cscott/rain-barrel/Transflective/README

To do:
1) add STEMMA QT socket(s)
2) add power regulator (5V to 3.3V)
3) add I2C resistors?
--
on base plate: (pads to regulate input to 12v (adj) / 5v / 3.3V) nah
2 STEMMA QT / 4 pin header(s)
(2) 3 pin (+5V / SIG / GND) header to supply (5V-diode drop) outside, and
 to supply 5V power
 connect to 5V backfeed on unused HUZZAH pin used in basement motor shield
Feather!
IDC connector to display
WATER_GPIO (another 5v/sig/gnd header?)
breadboard mounting
motor shield
rasp pi nano footprint -> (5V/SIG/GND) connector for snitch & routed i2c connection
----
To do: assign pin for DS_CS
Figure out how to wire-AND the pump pressure switch
  (maybe add an H-Bridge, and wire the switch to the enable input)
Routing
---
Both:
Feather!
Cap sense (i2c, 3.3V)
LCD (SPI)

Basement:
Motor Shield
Flow meter (i2c, +5V supply)
Smrty Snitch (i2c, is there a 5V supply?)
Water level sensor input?
Breadboard for smrty snitch
 (presumably 12V-ish input to motor shield, 12->5V conversion, 5V backfeed to feather through unused HUZZAH pin)

Outside:
ADS1115 A/D converter (i2c, 3.3V)
Breadboard (Vin to +/- 9V, 12V->5V switch converter, 2x 5V/SIG/GND one used to power magtag through 1N4001 diode)
 (how was the ADS1115 connected?)

Datasheets:

ADP1650 LED driver:
https://www.analog.com/media/en/technical-documentation/data-sheets/ADP1650.pdf
https://www.digikey.com/short/223nhvrn

CAP1298 Capacitive touch:
https://www.microchip.com/en-us/product/CAP1298
https://ww1.microchip.com/downloads/en/DeviceDoc/00001571B.pdf
https://www.microchip.com/content/dam/mchp/documents/OTH/ApplicationNotes/ApplicationNotes/01492A.pdf
App note: https://www.nxp.com/docs/en/application-note/AN3747.pdf

LCD panel: Displaytech 128240D FC BW-3 Graphic LCD
Digikey 1756-1047-ND or Mouser 758-S128240DFCBW-3
https://www.ebay.com/itm/293977786571
https://www.digikey.com/short/012dbnz2
https://www.seacomp.com/sites/default/files/datasheets/128240D-Series-Displaytech-Spec.pdf

Driver chip: ST7529:
https://www.sitronix.com.tw/en/products/industrial-display-driver-ic/gray-scale-stn-lcd-driver-ic/
https://www.crystalfontz.com/controllers/Sitronix/ST7529/
https://www.crystalfontz.com/controllers/Sitronix/ST7529/287/ (datasheet)

Waterproof enclosure: (haven't bought this yet)
https://www.adafruit.com/product/905
Dimensions https://cdn-shop.adafruit.com/datasheets/175mmenclosurediagram.pdf

(Alternative LED drivers:
https://www.diodes.com/assets/Datasheets/AL3644.pdf
https://www.ti.com/lit/ds/symlink/lm3642.pdf
)

Model of raspberry pi pico:
https://www.hackster.io/news/nicolo-carandini-s-3d-model-brings-an-accurate-raspberry-pi-pico-board-to-your-kicad-projects-7a2dffff9c56
Featherwing template:
https://github.com/ppelleti/FeatherWing-template-KiCad

Kicad helpers:
https://techexplorations.com/blog/kicad/blog-kicad-5-recipe-how-to-create-a-new-component-symbol/
https://techexplorations.com/kicad-4-book/index-p=112.html

BOM:                                       LCD        Rear       Have    Need
609-F314-1A7H1-11036CT-ND‎ (FPC connector)  1                              2 x
               (.01uF 0805 capacitor)      1                       8      -
732-8045-1-ND  (.1uF 0805 capacitor)       2                       9      -
732-7664-1-ND (1uF 0805 capacitor)         13                      9      4 x
732-7624-1-ND‎ (10 uF 0805 X5R capacitor)   2                              4 x
1175-1622-ND (2x7 SMD pin header)          1                              2 x
              STEMMA QT SMD                2           2          10      -
F12094CT-ND‎ (1uH 0805 inductor)            1                              2 x
RNCP0805FTD200RCT-ND (200 ohm 0805)        2                              4 x
RMCF0805JT10K0CT-ND (10k 0805)             2                              4 x
RMCF0805JT1M00CT-ND (1M 0805)              1                              2 x
CAP1298                                    1
ADP1650ACPZ-R7CT-ND (led driver)           1                       2      -
3.3V reg                                   1                      1+2     -
Feather headers                                         2         ?
SN74LVC1G02DBVRG4-ND (NOR gate)                         1                 -
  74LVC1G02W5-7DICT-ND‎                                                    1 x
2648-SC0915CT-ND (Raspberry Pi Pico)                    1                 1 x
THT 10k                                                 3       lots      -

0805 (2012 metric)
