cscott/rain-barrel/PCB-NOTES.txt

v1 of "Rear-Panel" PCB:

* OR gate should be 3.3V supply, not 5V
* 2x7 header should be rotated 180, either on this board or the other
* Swap F0 and F3
  (2022-03-19 why? apparently because F3 is hardware CS for SPI.
  DS_CS should be F3, Pressure switch should be F1
* Probably should have a jumper for LCD_RST
* Probably should add another schottkey diode heading *into* the 5V
  net, with a pad on the input to connect to external power
* Probably should label "A2" on the board as "5V IN"

v1 of "LCD Panel" PCB:
* The LED driver chip footprint has a center ground pad which
is much too large and threatens to short out against the pins
* C18 is stepped on by the 2x7 header.  "Use local reg" is a little
too close as well.
* Footprint for 2x7 header (a) pads should be wider, they don't reach
the ends of the pins which makes it hard to line up, and (b) the
silkscreen outline is too small, again can't be seen when the
component is placed.
* The X component of the top/bottom tabs is a little too large, needs
to be trimmed down to fit better.  (The side tabs are fine.)
* capacitors for LCD are wrong (see Transflective/NOTES.txt)

(see also Transflective/NOTES.txt)
