cscott/rain-barrel/feather-top.stl

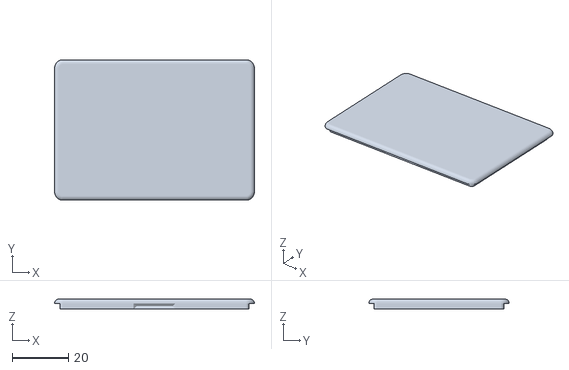
[picture p1: CAD file, 2021-06-01]
feather-top.stl
71.0 x 49.9 x 3.50
