cscott/rain-barrel/Transflective/ADP1650ACPZR7/CP_10_9_ADI.step

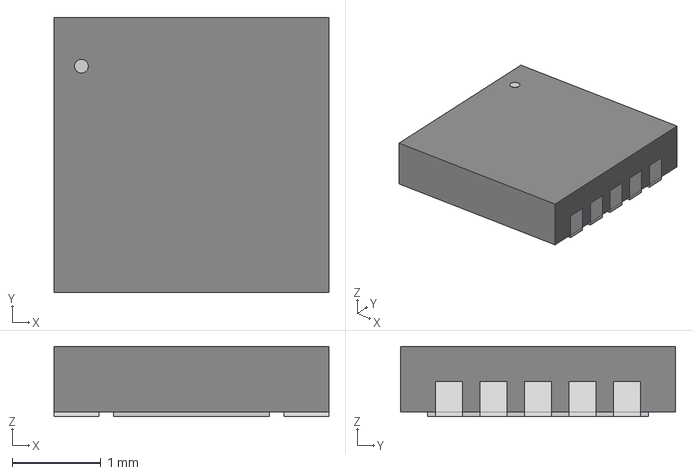
[picture p2: CAD file, 2021-09-28]
Transflective/ADP1650ACPZR7/CP_10_9_ADI.step
3.10 x 3.10 x 0.79 mm
