cscott/rain-barrel/Transflective/LCD-Fixup/BM04B-SRSS-TB-LF--SN---3DModel-STEP-56544.STEP

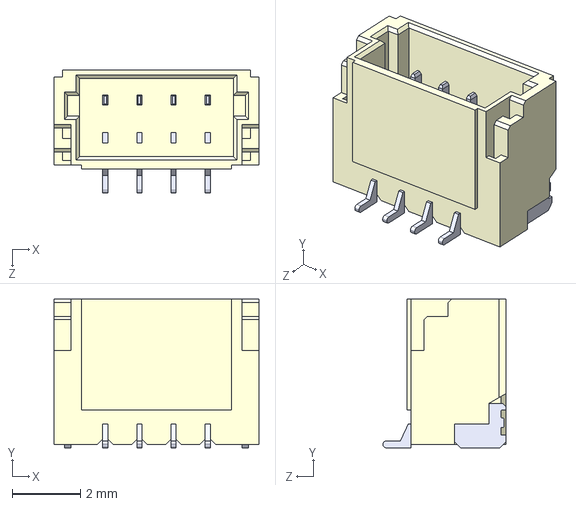
[picture p3: CAD file, 2021-10-04]
Transflective/LCD-Fixup/BM04B-SRSS-TB-LF--SN---3DModel-STEP-56544.STEP
6.00 x 4.35 x 3.60 mm
