cscott/rain-barrel/Transflective/Rear-Panel/B3B-XH-A-LF--SN---3DModel-STEP-269445.STEP

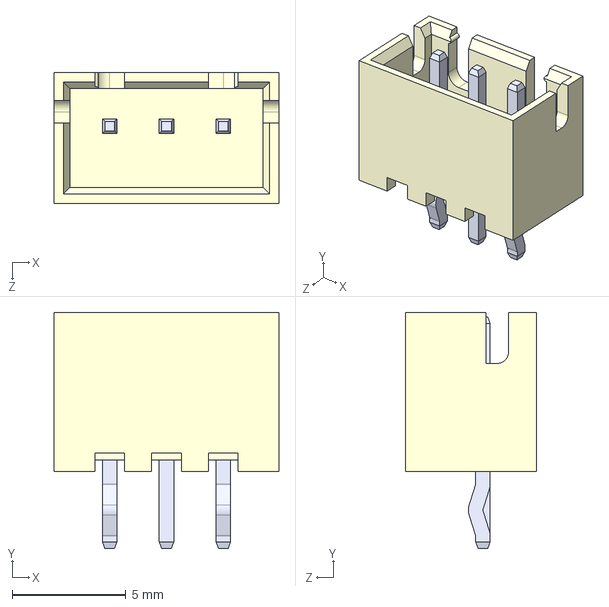
[picture p4: CAD file, 2021-10-04]
Transflective/Rear-Panel/B3B-XH-A-LF--SN---3DModel-STEP-269445.STEP
9.90 x 10.4 x 5.75 mm
