cscott/rain-barrel/esp32-rainbarrel/test/test_desktop/README.md

This directory contains tests to run natively on the host.
