cscott/rain-barrel/Transflective/Rear-Panel/Transflective.pdf

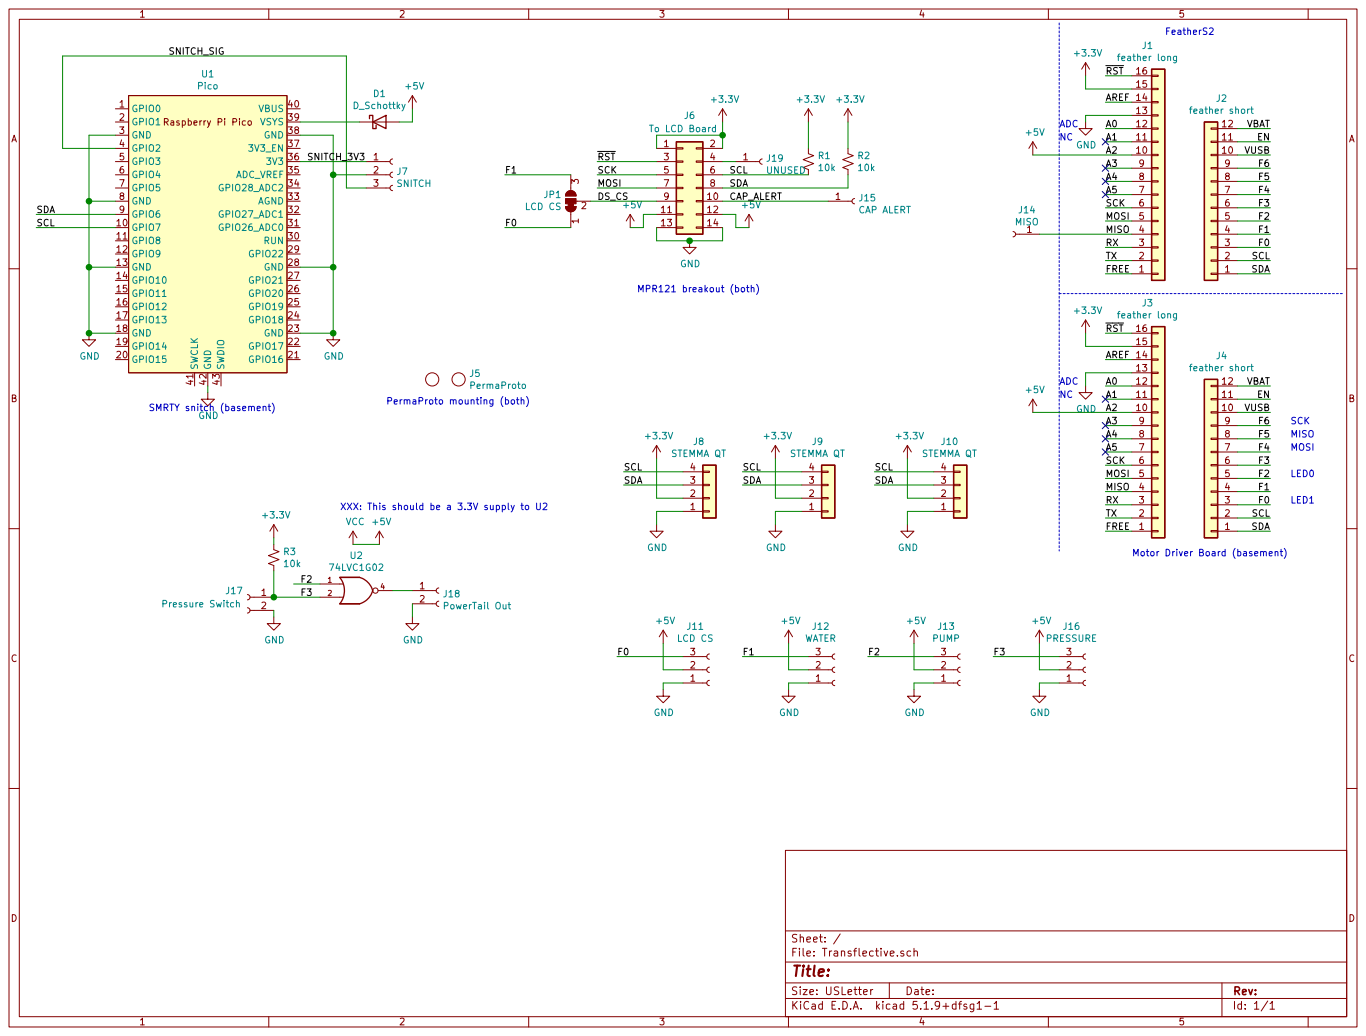
[picture p5: page 1]

PermaProto mounting (both) SMRTY snitch (basement)

Motor Driver Board (basement)

Id: 1/1 Title: File: Transflective.sch Sheet: /
