cscott/rain-barrel/Transflective/LCD-Tester/LCD-Tester.pdf

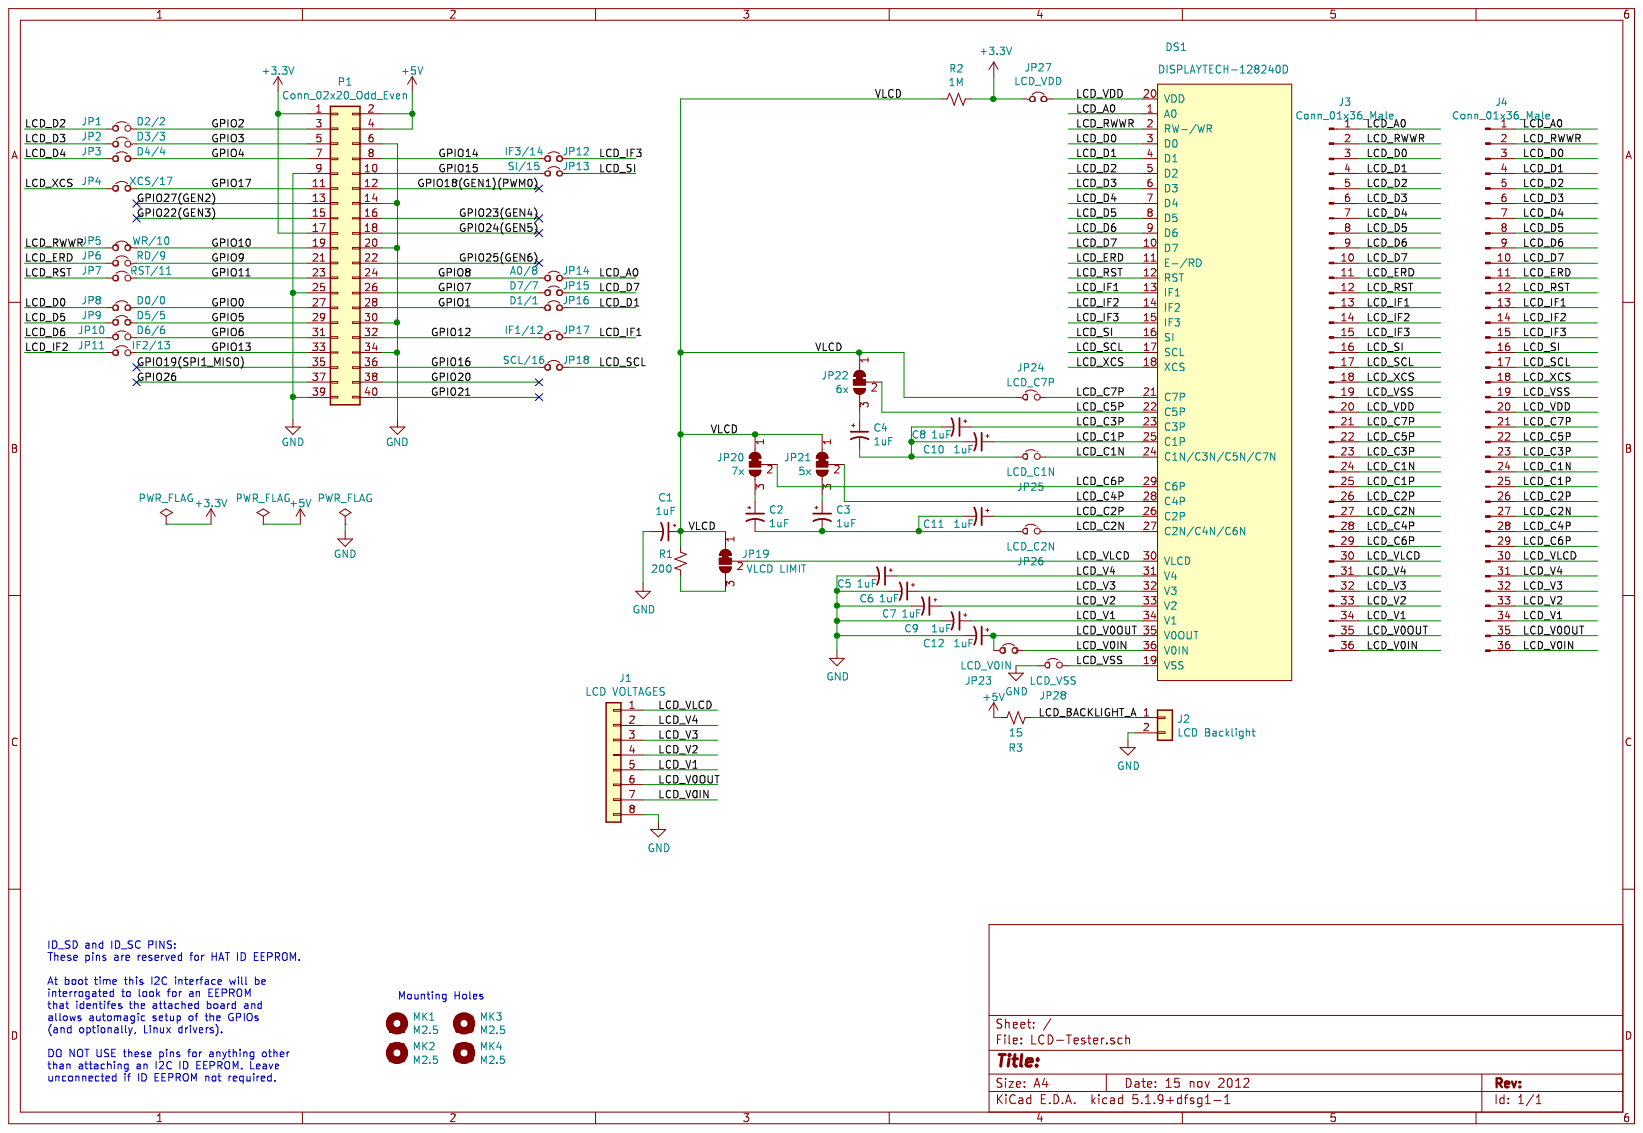
[picture p6: page 1]
