cscott/rain-barrel/Transflective/LCD-Panel/LCD-panel.pdf

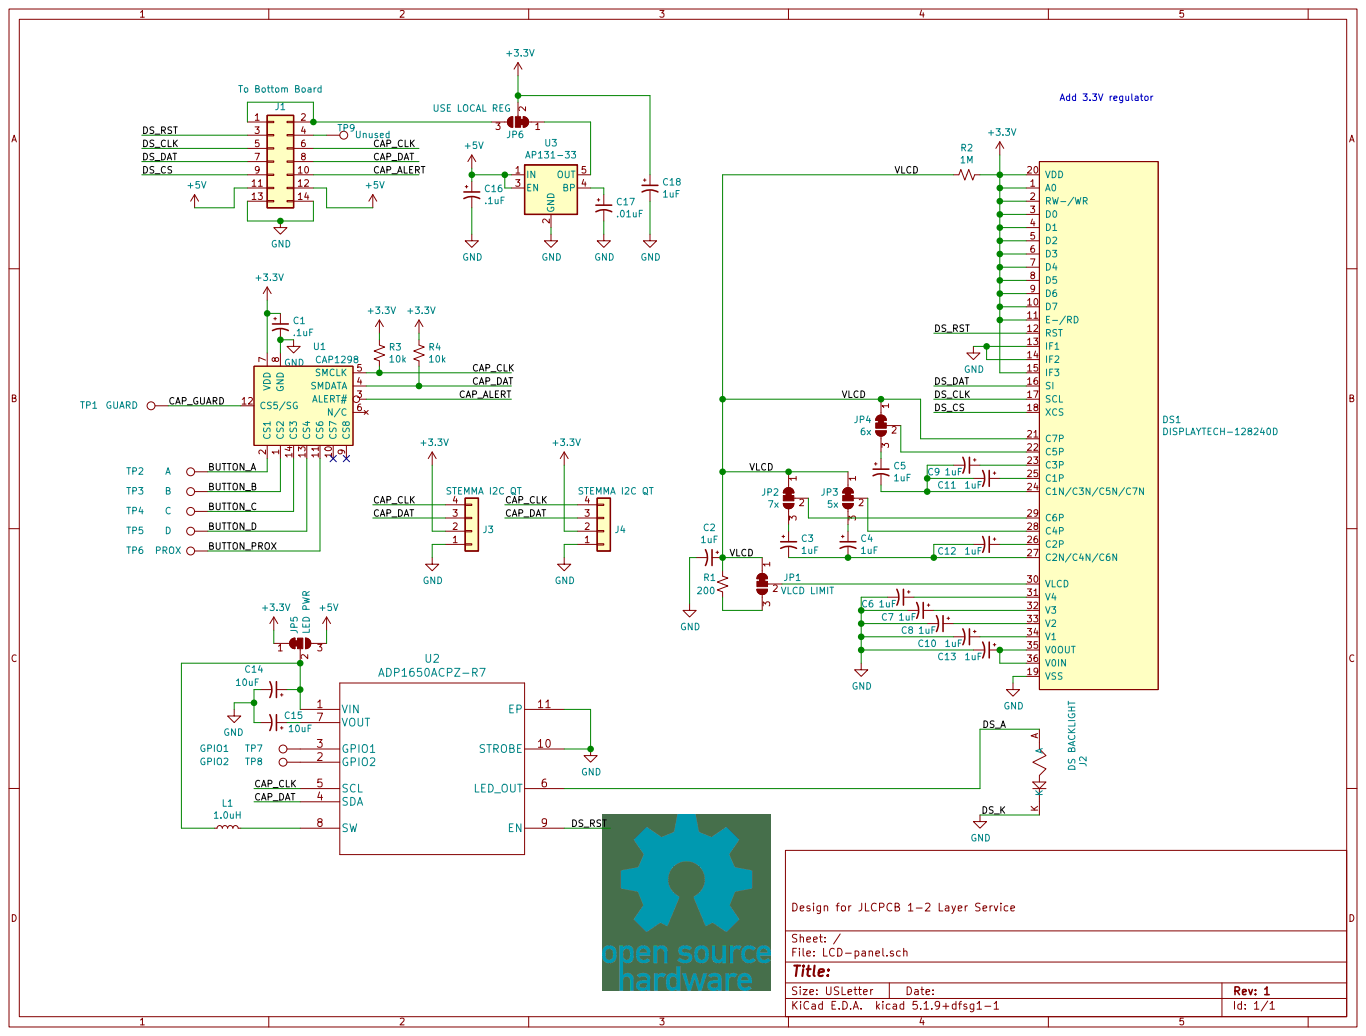
[picture p7: page 1]

2 ALERT# 3 SMDATA 4 SMCLK 5 N/C 6 VDD

File: LCD-panel.sch Sheet: / Design for JLCPCB 1-2 Layer Service
