cscott/rain-barrel/(list of files, drawings)

Other design files:
LevelAmps.fzz
SMRTYComparator.fzz
SMRTYSnitch2.fzz
SMRTYSnitch3.fzz
SMRTYSnitch.fzz
