cscott/rain-barrel/Transflective/Turbine-PCB/Turbine-PCB.kicad_pcb

## KiCad design Transflective/Turbine-PCB/Turbine-PCB.kicad_pcb (2023-07-10)

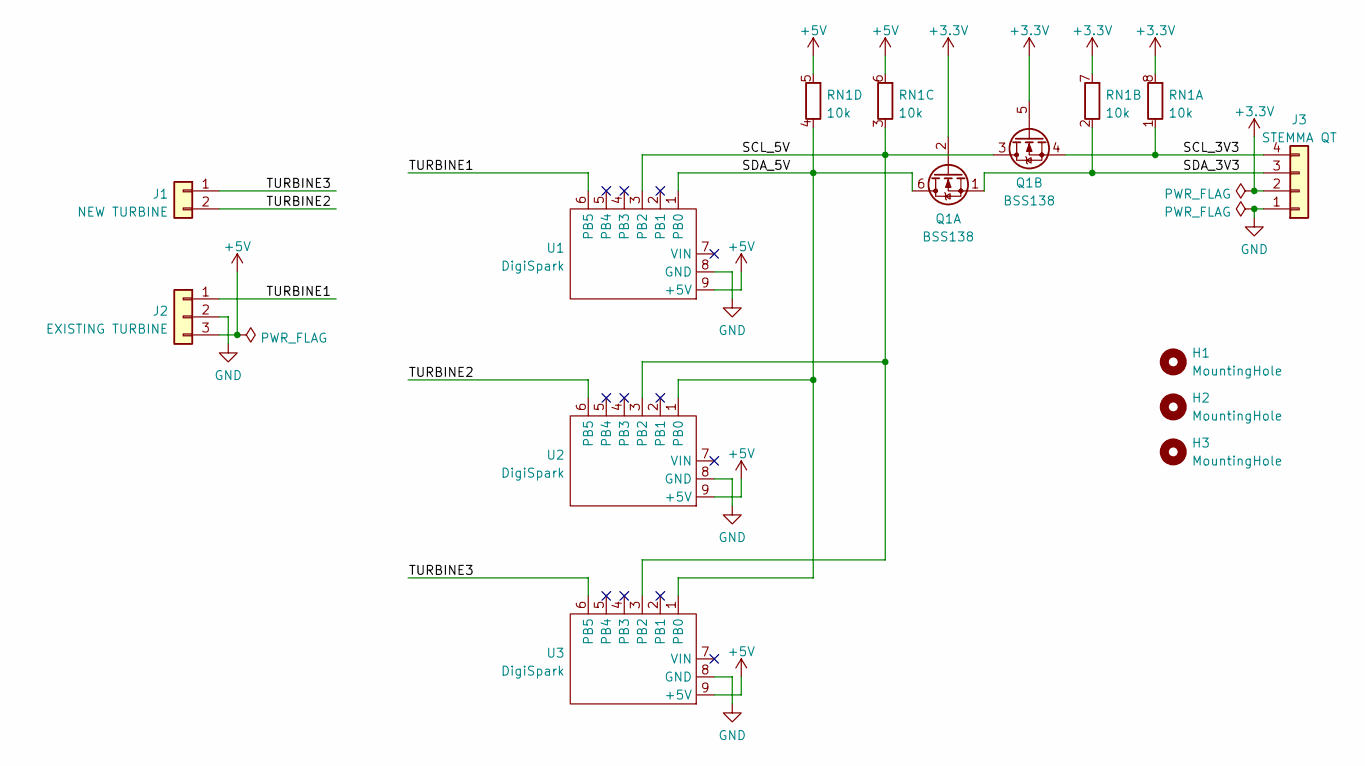
[picture p8: schematic Turbine-PCB.kicad_sch]

Parts:
H1, H2, H3: MountingHole; MountingHole_3.2mm_M3
J1: NEW TURBINE; JST_XH_B2B-XH-A_1x02_P2.50mm_Vertical
J2: EXISTING TURBINE; JST_XH_B3B-XH-A_1x03_P2.50mm_Vertical
J3: STEMMA QT; JST-SH-4-VERT-SMD
Q1: BSS138; SOT-363_SC-70-6_Handsoldering
RN1: 10k; R_Array_Convex_4x1206
U1, U2, U3: DigiSpark; Digispark

Connections:
+3.3V: J3.2, Q1.2 (G), Q1.5 (G), RN1.7 (R2.2), RN1.8 (R1.2)
+5V: J2.3, RN1.5 (R4.2), RN1.6 (R3.2), U1.9 (+5V), U2.9 (+5V), U3.9 (+5V)
/SCL_3V3: J3.4, Q1.4 (S), RN1.1 (R1.1)
/SCL_5V: Q1.3 (D), RN1.3 (R3.1), U1.3 (PB2), U2.3 (PB2), U3.3 (PB2)
/SDA_3V3: J3.3, Q1.1 (S), RN1.2 (R2.1)
/SDA_5V: Q1.6 (D), RN1.4 (R4.1), U1.1 (PB0), U2.1 (PB0), U3.1 (PB0)
/TURBINE1: J2.1, U1.6 (PB5)
/TURBINE2: J1.2, U2.6 (PB5)
/TURBINE3: J1.1, U3.6 (PB5)
GND: J2.2, J3.1, U1.8 (GND), U2.8 (GND), U3.8 (GND)

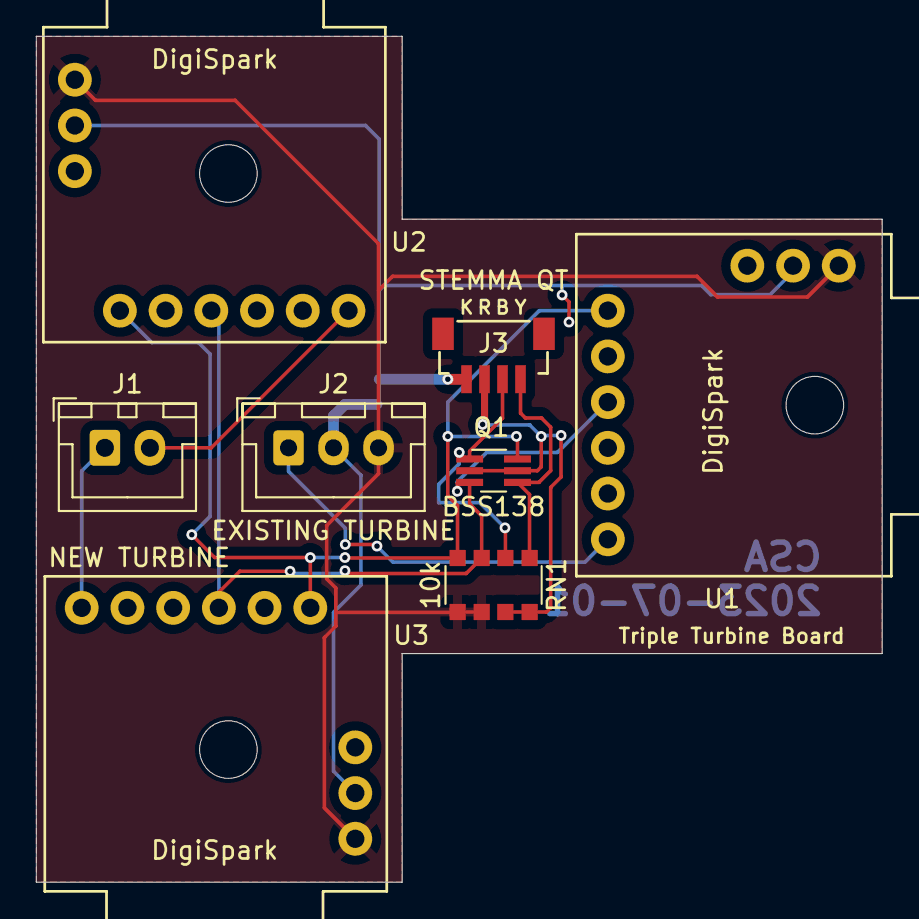
[picture p9: board Turbine-PCB.kicad_pcb from above]

Board: 2 copper layers, 47.0 x 47.0 mm, 11 parts (0 on the bottom side), 10 nets.
