cscott/rain-barrel/Transflective/Level-Amp-PCB/Level-Amp-PCB.kicad_pcb

## KiCad design Transflective/Level-Amp-PCB/Level-Amp-PCB.kicad_pcb (2023-07-10)

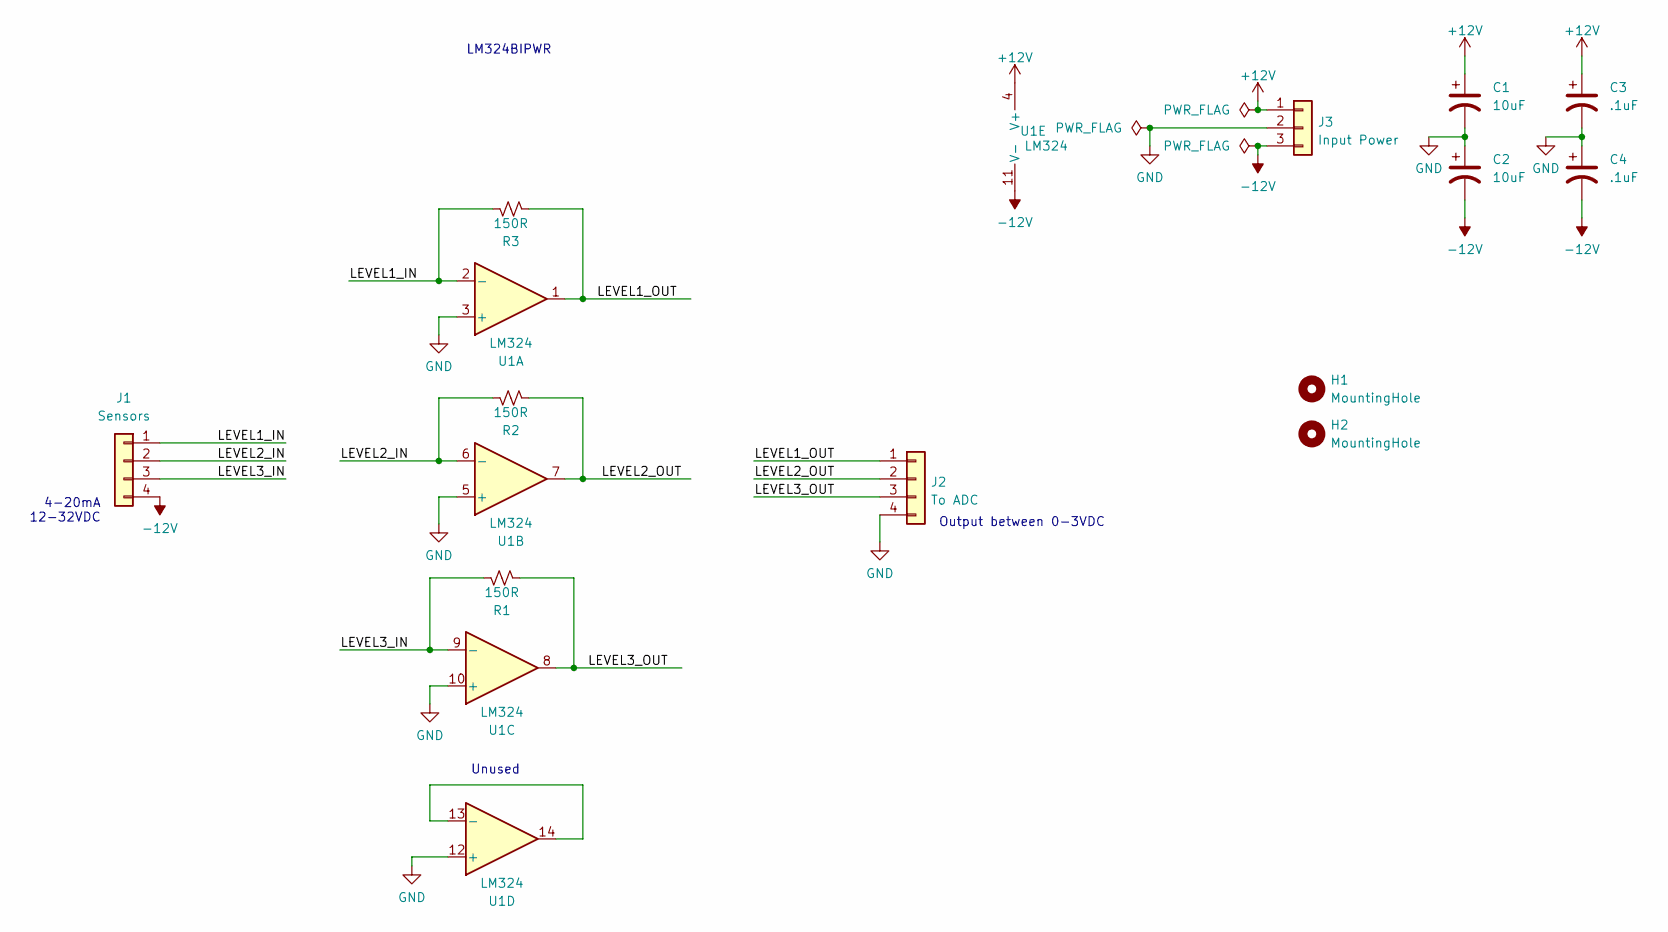
[picture p10: schematic Level-Amp-PCB.kicad_sch]

Parts:
C1, C2: 10uF; CP_EIA-2012-15_AVX-P_Pad1.30x1.05mm_HandSolder
C3, C4: .1uF; CP_EIA-2012-15_AVX-P_Pad1.30x1.05mm_HandSolder
H1, H2: MountingHole; MountingHole_3.2mm_M3
J1: Sensors; JST_XH_B4B-XH-A_1x04_P2.50mm_Vertical
J2: To ADC; JST_XH_B4B-XH-A_1x04_P2.50mm_Vertical
J3: Input Power; JST_XH_B3B-XH-A_1x03_P2.50mm_Vertical
R1, R2, R3: 150R; R_0805_2012Metric_Pad1.20x1.40mm_HandSolder
U1: LM324; TSSOP-14_4.4x5mm_P0.65mm

Connections:
+12V: C1.1, C3.1, J3.1, U1.4 (V+)
-12V: C2.2, C4.2, J1.4, J3.3, U1.11 (V-)
/LEVEL1_IN: J1.1, R3.1, U1.2 (-)
/LEVEL1_OUT: J2.1, R3.2, U1.1
/LEVEL2_IN: J1.2, R2.1, U1.6 (-)
/LEVEL2_OUT: J2.2, R2.2, U1.7
/LEVEL3_IN: J1.3, R1.1, U1.9 (-)
/LEVEL3_OUT: J2.3, R1.2, U1.8
GND: C1.2, C2.1, C3.2, C4.1, J2.4, J3.2, U1.3 (+), U1.5 (+), U1.10 (+), U1.12 (+)
unnamed: U1.13 (-), U1.14

Notes on the sheet:
4-20mA 12-32VDC
Output between 0-3VDC
LM324BIPWR
Unused

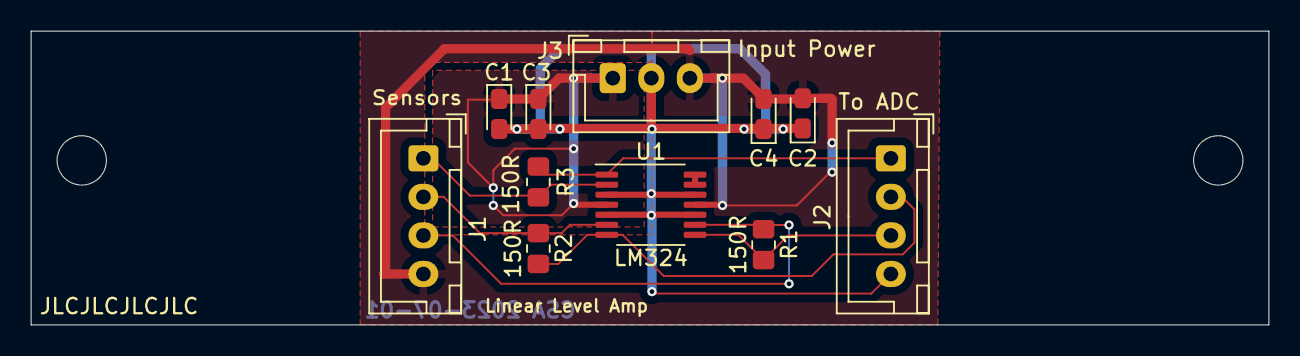
[picture p11: board Level-Amp-PCB.kicad_pcb from above]

Board: 2 copper layers, 80.3 x 19.1 mm, 13 parts (0 on the bottom side), 10 nets.
