cscott/rain-barrel/Transflective/Level-Chopper/Level-Chopper.kicad_pcb

## KiCad design Transflective/Level-Chopper/Level-Chopper.kicad_pcb (2023-07-10)

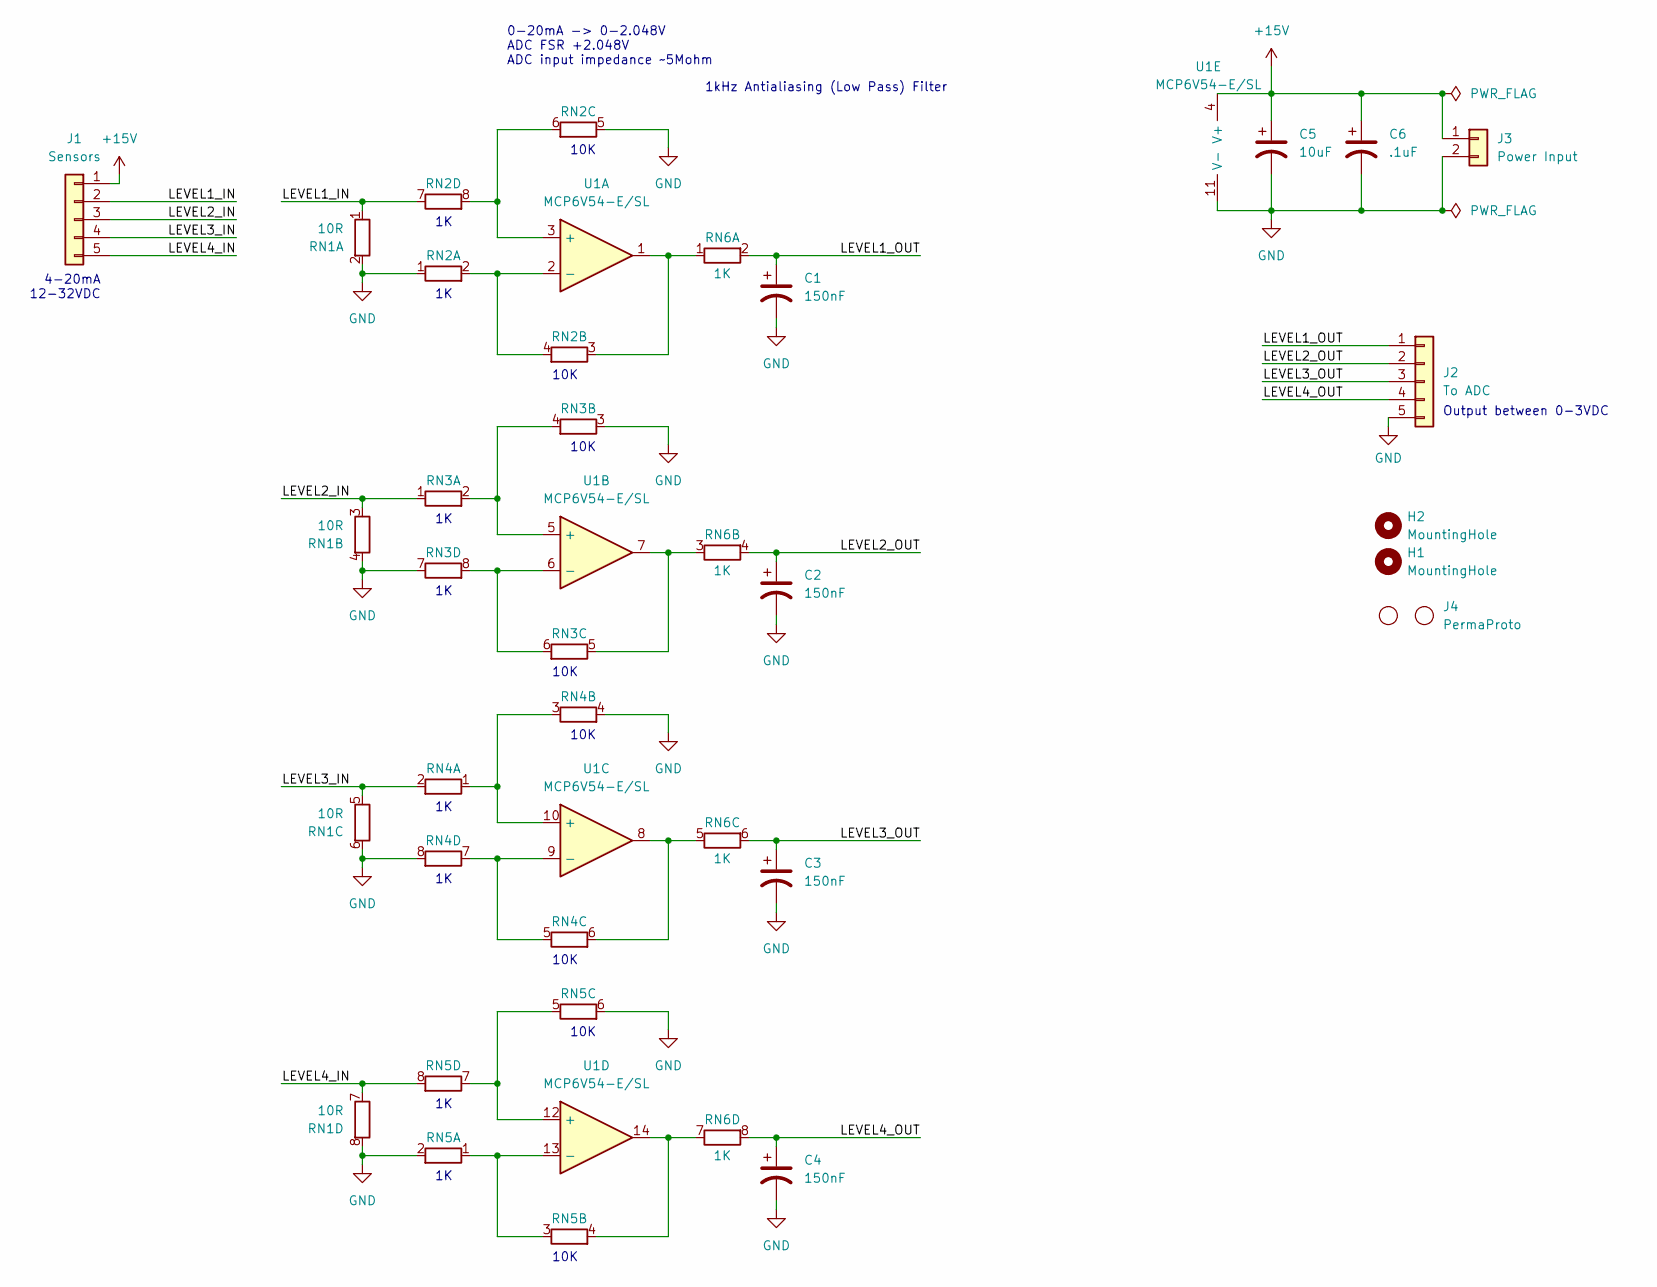
[picture p12: schematic Level-Chopper.kicad_sch]

Parts:
C1, C2, C3, C4: 150nF; CP_EIA-2012-15_AVX-P_Pad1.30x1.05mm_HandSolder
C5: 10uF; CP_EIA-2012-15_AVX-P_Pad1.30x1.05mm_HandSolder
C6: .1uF; CP_EIA-2012-15_AVX-P_Pad1.30x1.05mm_HandSolder
H1, H2: MountingHole; MountingHole_3.2mm_M3
J1: Sensors; JST_XH_B5B-XH-A_1x05_P2.50mm_Vertical
J2: To ADC; JST_XH_B5B-XH-A_1x05_P2.50mm_Vertical
J3: Power Input; JST_XH_B2B-XH-A_1x02_P2.50mm_Vertical
J4: PermaProto
RN1: 10R; RES_ACAS_0612_VIS
RN2, RN3, RN4, RN5: 1K/10k; RES_ACAS_0612_VIS
RN6: 1K; RES_ACAS_0612_VIS
U1: MCP6V54-E/SL; SOIC-14_3.9x8.7mm_P1.27mm

Connections:
+15V: C5.1, C6.1, J1.1, J3.1, U1.4 (V+)
/LEVEL1_IN: J1.2, RN1.1 (R1.1), RN2.7 (R4.1)
/LEVEL1_OUT: C1.1, J2.1, RN6.2 (R1.2)
/LEVEL2_IN: J1.3, RN1.3 (R2.1), RN3.1 (R1.1)
/LEVEL2_OUT: C2.1, J2.2, RN6.4 (R2.2)
/LEVEL3_IN: J1.4, RN1.5 (R3.1), RN4.2 (R1.2)
/LEVEL3_OUT: C3.1, J2.3, RN6.6 (R3.2)
/LEVEL4_IN: J1.5, RN1.7 (R4.1), RN5.8 (R4.2)
/LEVEL4_OUT: C4.1, J2.4, RN6.8 (R4.2)
GND: C1.2, C2.2, C3.2, C4.2, C5.2, C6.2, J2.5, J3.2, RN1.2 (R1.2), RN1.4 (R2.2), RN1.6 (R3.2), RN1.8 (R4.2), RN2.1 (R1.1), RN2.5 (R3.1), RN3.3 (R2.1), RN3.7 (R4.1), RN4.4 (R2.2), RN4.8 (R4.2), RN5.2 (R1.2), RN5.6 (R3.2), U1.11 (V-)
unnamed: RN2.2 (R1.2), RN2.4 (R2.2), U1.2 (-)
unnamed: RN2.3 (R2.1), RN6.1 (R1.1), U1.1
unnamed: RN2.6 (R3.2), RN2.8 (R4.2), U1.3 (+)
unnamed: RN3.2 (R1.2), RN3.4 (R2.2), U1.5 (+)
unnamed: RN3.5 (R3.1), RN6.3 (R2.1), U1.7
unnamed: RN3.6 (R3.2), RN3.8 (R4.2), U1.6 (-)
unnamed: RN4.1 (R1.1), RN4.3 (R2.1), U1.10 (+)
unnamed: RN4.5 (R3.1), RN4.7 (R4.1), U1.9 (-)
unnamed: RN4.6 (R3.2), RN6.5 (R3.1), U1.8
unnamed: RN5.1 (R1.1), RN5.3 (R2.1), U1.13 (-)
unnamed: RN5.4 (R2.2), RN6.7 (R4.1), U1.14
unnamed: RN5.5 (R3.1), RN5.7 (R4.1), U1.12 (+)

Notes on the sheet:
0-20mA -> 0-2.048V ADC FSR +2.048V ADC input impedance ~5Mohm
1kHz Antialiasing (Low Pass) Filter
10K
4-20mA 12-32VDC
Output between 0-3VDC

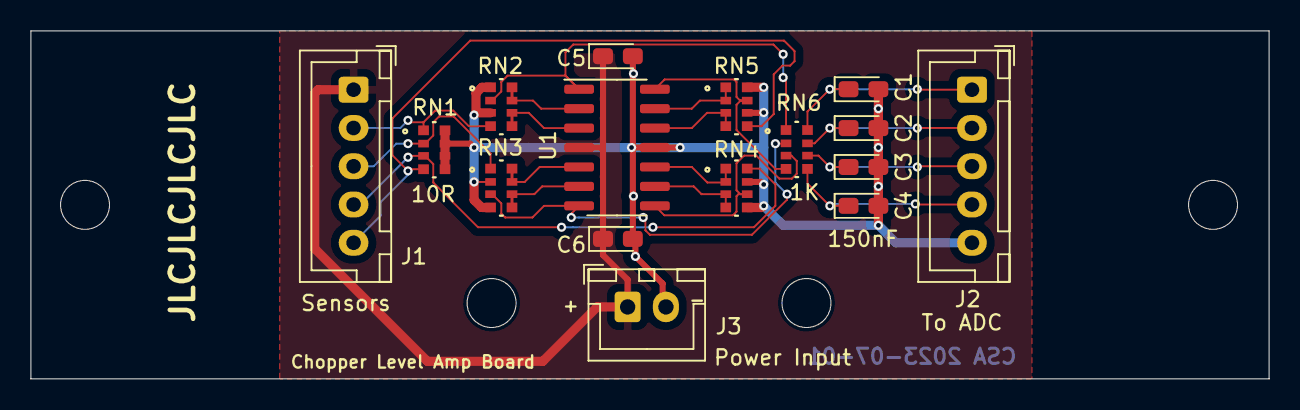
[picture p13: board Level-Chopper.kicad_pcb from above]

Board: 2 copper layers, 80.9 x 22.7 mm, 19 parts (0 on the bottom side), 22 nets.
