cscott/rain-barrel/Transflective/Snitch-2/Snitch-2.kicad_pcb

## KiCad design Transflective/Snitch-2/Snitch-2.kicad_pcb (2023-07-10)

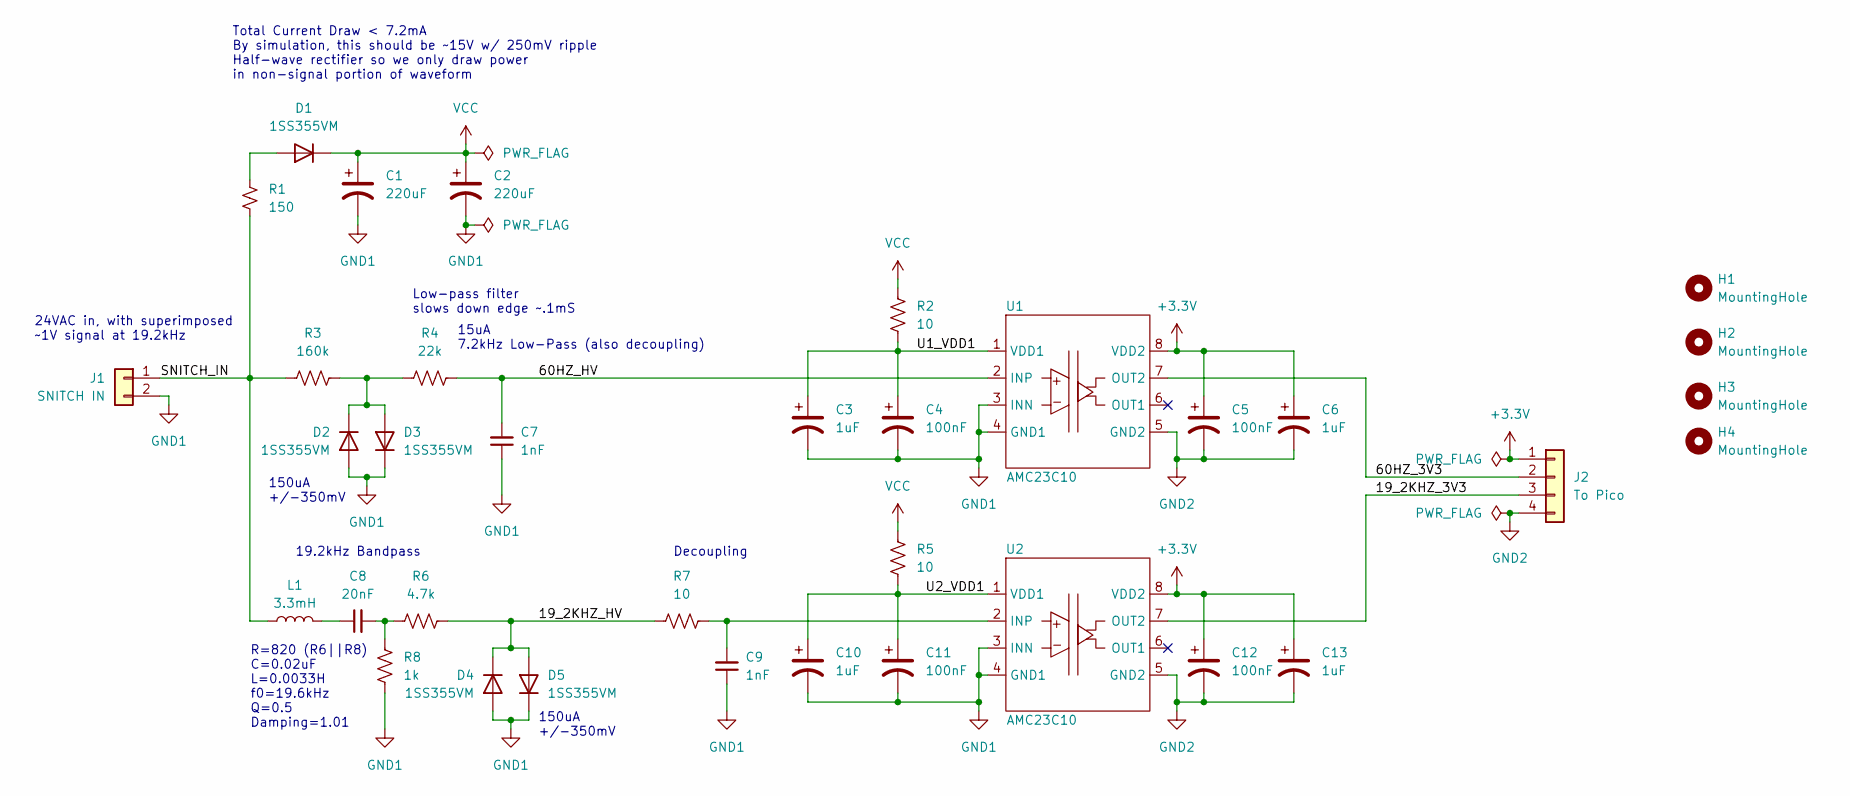
[picture p14: schematic Snitch-2.kicad_sch]

Parts:
C1, C2: 220uF; CP_Elec_13.7x13
C3, C6, C10, C13: 1uF; C_0805_2012Metric_Pad1.18x1.45mm_HandSolder
C4, C5, C11, C12: 100nF; C_0805_2012Metric_Pad1.18x1.45mm_HandSolder
C7, C9: 1nF; C_0805_2012Metric_Pad1.18x1.45mm_HandSolder
C8: 20nF; C_0805_2012Metric_Pad1.18x1.45mm_HandSolder
D1, D2, D3, D4, D5: 1SS355VM; D_SOD-323F
H1, H2, H3, H4: MountingHole; MountingHole_3.2mm_M3
J1: SNITCH IN; JST_XH_B2B-XH-A_1x02_P2.50mm_Vertical
J2: To Pico; JST_XH_B4B-XH-A_1x04_P2.50mm_Vertical
L1: 3.3mH; L_Bourns_SDR0805
R1: 150; R_0805_2012Metric_Pad1.20x1.40mm_HandSolder
R2, R5, R7: 10; R_0805_2012Metric_Pad1.20x1.40mm_HandSolder
R3: 160k; R_0805_2012Metric_Pad1.20x1.40mm_HandSolder
R4: 22k; R_0805_2012Metric_Pad1.20x1.40mm_HandSolder
R6: 4.7k; R_0805_2012Metric_Pad1.20x1.40mm_HandSolder
R8: 1k; R_0805_2012Metric_Pad1.20x1.40mm_HandSolder
U1, U2: AMC23C10; SOIC-8_7.5x5.85mm_P1.27mm

Connections:
+3.3V: C5.1, C6.1, C12.1, C13.1, J2.1, U1.8 (VDD2), U2.8 (VDD2)
/19_2KHZ_3V3: J2.3, U2.7 (OUT2)
/19_2KHZ_HV: D4.1 (K), D5.2 (A), R6.2, R7.1
/60HZ_3V3: J2.2, U1.7 (OUT2)
/60HZ_HV: C7.2, R4.2, U1.2 (INP)
/SNITCH_IN: J1.1, L1.1, R1.2, R3.1
/U1_VDD1: C3.1, C4.1, R2.1, U1.1 (VDD1)
/U2_VDD1: C10.1, C11.1, R5.1, U2.1 (VDD1)
GND1: C1.2, C2.2, C3.2, C4.2, C7.1, C9.1, C10.2, C11.2, D2.2 (A), D3.1 (K), D4.2 (A), D5.1 (K), J1.2, R8.1, U1.3 (INN), U1.4 (GND1), U2.3 (INN), U2.4 (GND1)
GND2: C5.2, C6.2, C12.2, C13.2, J2.4, U1.5 (GND2), U2.5 (GND2)
unnamed: C8.1, L1.2
unnamed: C8.2, R6.1, R8.2
unnamed: D1.2 (A), R1.1
unnamed: D2.1 (K), D3.2 (A), R3.2, R4.1
unnamed: C9.2, R7.2, U2.2 (INP)
VCC: C1.1, C2.1, D1.1 (K), R2.2, R5.2

Notes on the sheet:
R=820 (R6||R8) C=0.02uF L=0.0033H f0=19.6kHz Q=0.5 Damping=1.01
24VAC in, with superimposed ~1V signal at 19.2kHz
Total Current Draw < 7.2mA By simulation, this should be ~15V w/ 250mV ripple Half-wave rectifier so we only draw power in non-signal portion of waveform
Decoupling
Low-pass filter slows down edge ~.1mS
15uA 7.2kHz Low-Pass (also decoupling)
150uA +/-350mV
19.2kHz Bandpass

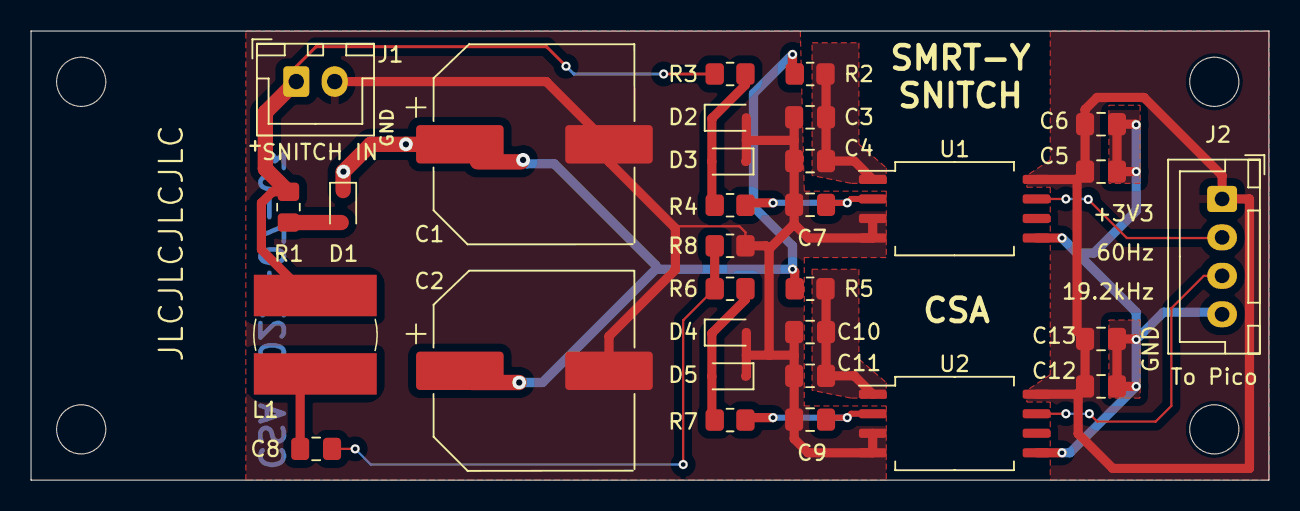
[picture p15: board Snitch-2.kicad_pcb from above]

Board: 2 copper layers, 80.5 x 29.2 mm, 35 parts (0 on the bottom side), 16 nets.
