cscott/rain-barrel/Transflective/Rear-Panel/Transflective.kicad_pcb

## KiCad design Transflective/Rear-Panel/Transflective.kicad_pcb (2023-07-04)

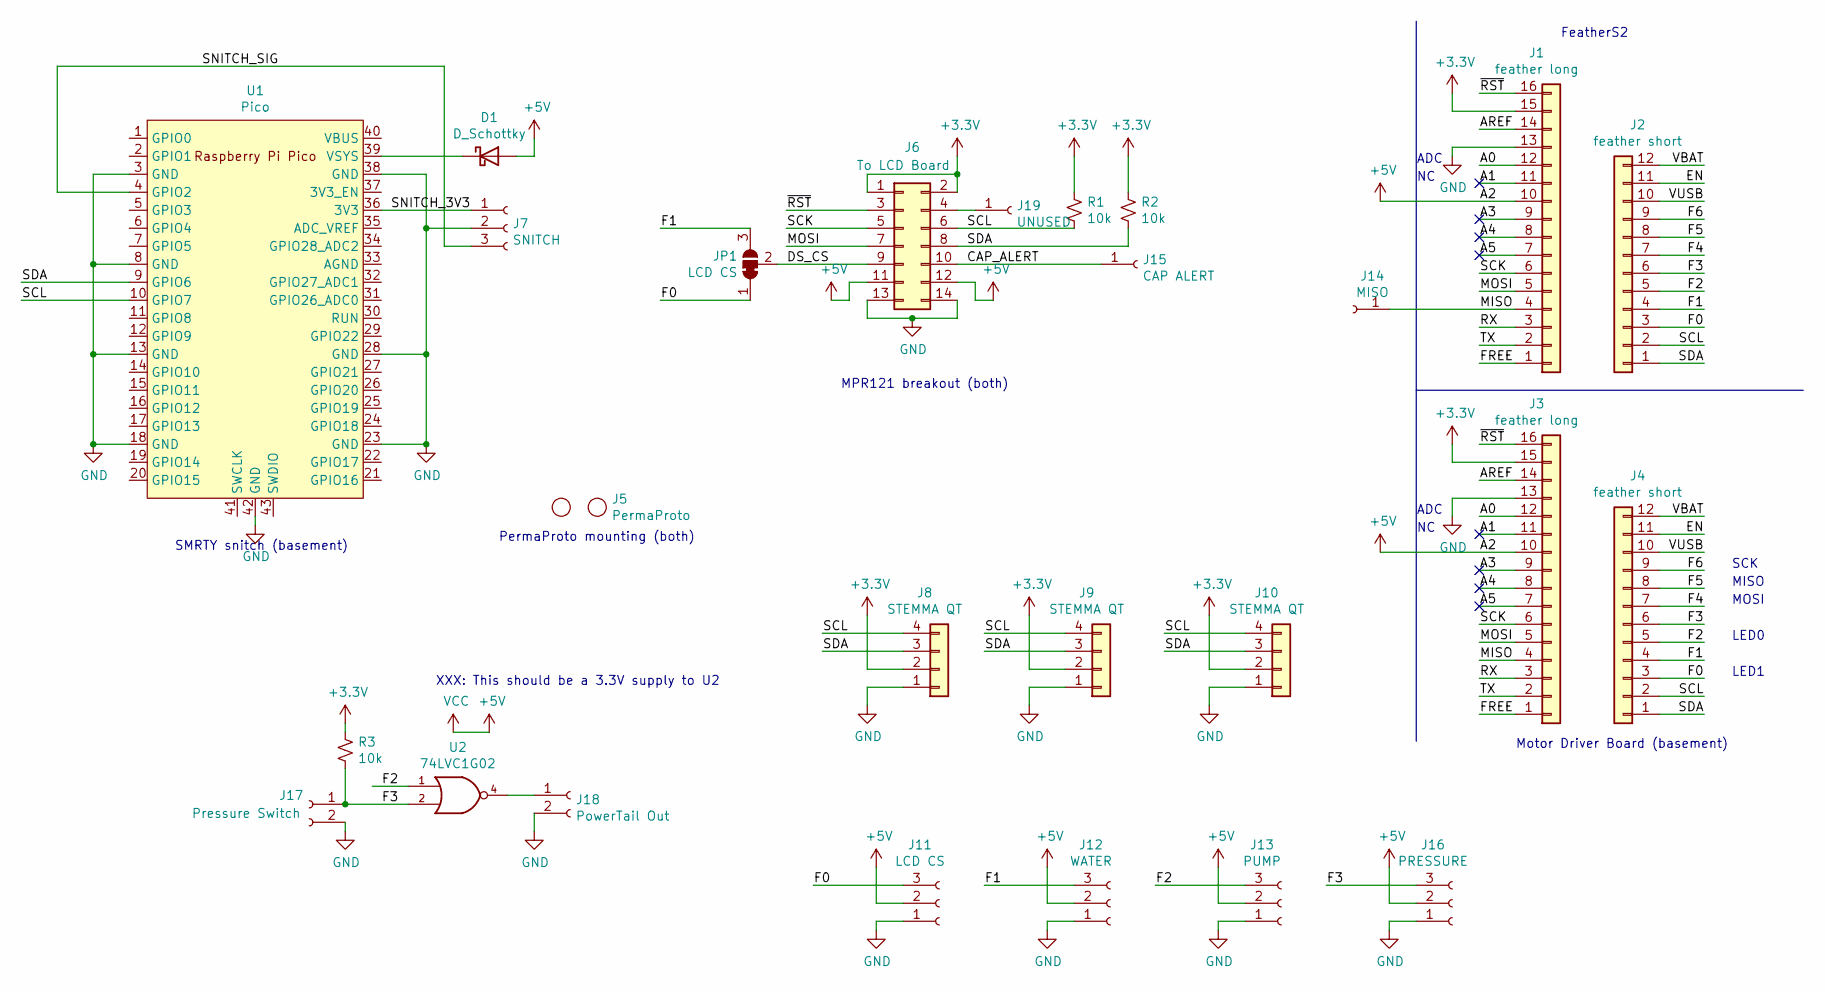
[picture p16: schematic Transflective.kicad_sch]

Parts:
D1: D_Schottky; D_DO-41_SOD81_P10.16mm_Horizontal
J1, J3: feather long; PinHeader_1x16_P2.54mm_Vertical
J2, J4: feather short; PinHeader_1x12_P2.54mm_Vertical
J5: PermaProto
J6: To LCD Board; IDC-Header_2x07_P2.54mm_Vertical
J7: SNITCH; JST_XH_B03B-XH-AM_1x03_P2.50mm_Vertical
J8, J9: STEMMA QT; JST-SH-4-VERT-SMD
J10: STEMMA QT; JST_XH_B04B-XH-AM_1x04_P2.50mm_Vertical
J11: LCD CS; JST_XH_B03B-XH-AM_1x03_P2.50mm_Vertical
J12: WATER; JST_XH_B03B-XH-AM_1x03_P2.50mm_Vertical
J13: PUMP; JST_XH_B03B-XH-AM_1x03_P2.50mm_Vertical
J14: MISO; PinHeader_1x01_P2.54mm_Vertical
J15: CAP ALERT; PinHeader_1x01_P2.54mm_Vertical
J16: PRESSURE; JST_XH_B03B-XH-AM_1x03_P2.50mm_Vertical
J17: Pressure Switch; JST_XH_B02B-XH-AM_1x02_P2.50mm_Vertical
J18: PowerTail Out; JST_XH_B02B-XH-AM_1x02_P2.50mm_Vertical
J19: UNUSED; PinHeader_1x01_P2.54mm_Vertical
JP1: LCD CS; SolderJumper-3_P1.3mm_Bridged2Bar12_RoundedPad1.0x1.5mm
R1, R2, R3: 10k; R_Axial_DIN0207_L6.3mm_D2.5mm_P10.16mm_Horizontal
U1: Pico; RPi_Pico_SMD_TH
U2: 74LVC1G02; SOT-23-5_HandSoldering

Connections:
+3V3: J1.15, J3.15, J6.1, J6.2, J8.2, J9.2, J10.2, R1.1, R2.1, R3.1
+5V: D1.2 (A), J1.10, J3.10, J6.11, J6.12, J11.2, J12.2, J13.2, J16.2, U2.5 (VCC)
/A0: J1.12, J3.12
/A1: J1.11, J3.11
/A3: J1.9, J3.9
/A4: J1.8, J3.8
/A5: J1.7, J3.7
/AREF: J1.14, J3.14
/CAP_ALERT: J6.10, J15.1
/DS_CS: J6.9, JP1.2 (C)
/EN: J2.11, J4.11
/F0: J2.3, J4.3, J11.3, JP1.1 (A)
/F1: J2.4, J4.4, J12.3, JP1.3 (B)
/F2: J2.5, J4.5, J13.3, U2.1
/F3: J2.6, J4.6, J16.3, J17.1, R3.2, U2.2
/F4: J2.7, J4.7
/F5: J2.8, J4.8
/F6: J2.9, J4.9
/FREE: J1.1, J3.1
/MISO: J1.4, J3.4, J14.1
/MOSI: J1.5, J3.5, J6.7
/RX: J1.3, J3.3
/SCK: J1.6, J3.6, J6.5
/SCL: J2.2, J4.2, J6.6, J8.4, J9.4, J10.4, R1.2, U1.10 (GPIO7)
/SDA: J2.1, J4.1, J6.8, J8.3, J9.3, J10.3, R2.2, U1.9 (GPIO6)
/SNITCH_3V3: J7.1, U1.36 (3V3)
/SNITCH_SIG: J7.3, U1.4 (GPIO2)
/TX: J1.2, J3.2
/VBAT: J2.12, J4.12
/VUSB: J2.10, J4.10
/~RST: J1.16, J3.16, J6.3
GND: J1.13, J3.13, J6.13, J6.14, J7.2, J8.1, J9.1, J10.1, J11.1, J12.1, J13.1, J16.1, J17.2, J18.2, U1.3 (GND), U1.8 (GND), U1.13 (GND), U1.18 (GND), U1.23 (GND), U1.28 (GND), U1.38 (GND), U1.42 (GND), U2.3 (GND)
unnamed: D1.1 (K), U1.39 (VSYS)
unnamed: J18.1, U2.4
unnamed: J6.4, J19.1

Notes on the sheet:
XXX: This should be a 3.3V supply to U2
FeatherS2
LED0
MISO
LED1
MOSI
ADC
Motor Driver Board (basement)
SMRTY snitch (basement)
MPR121 breakout (both)
PermaProto mounting (both)
SCK

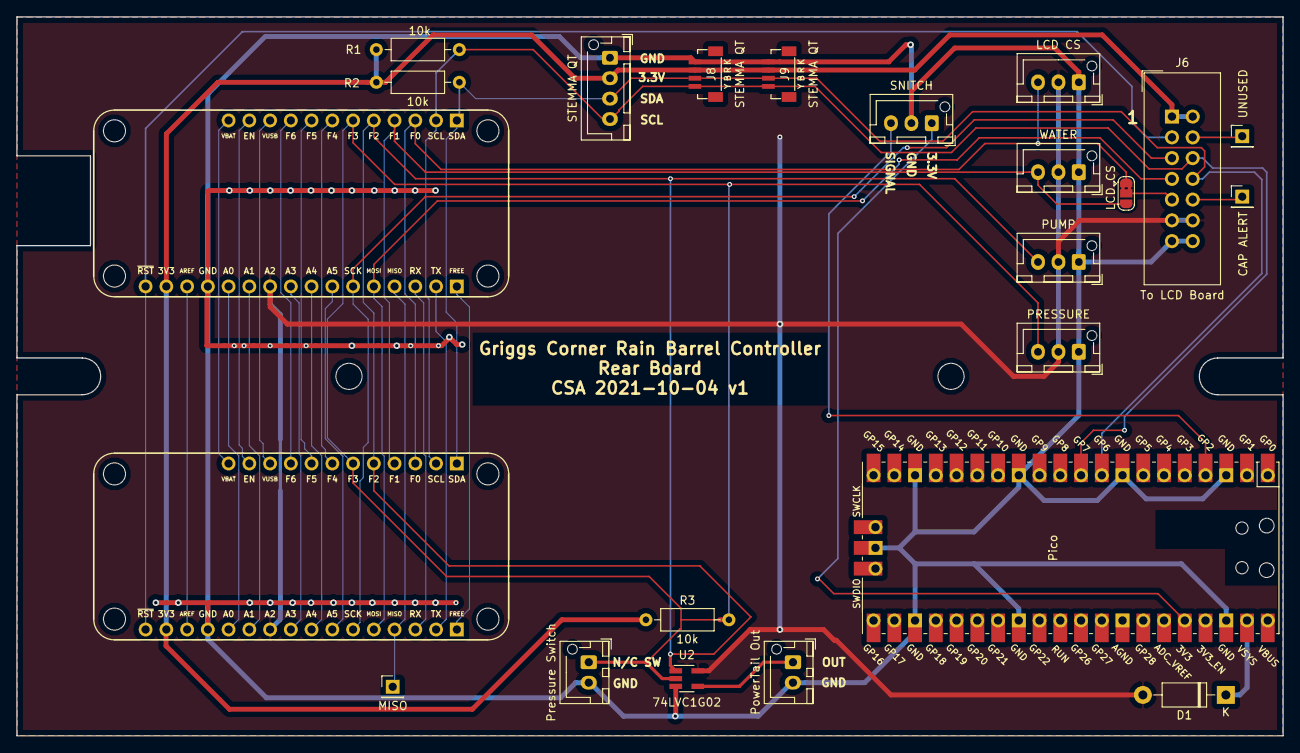
[picture p17: board Transflective.kicad_pcb from above]

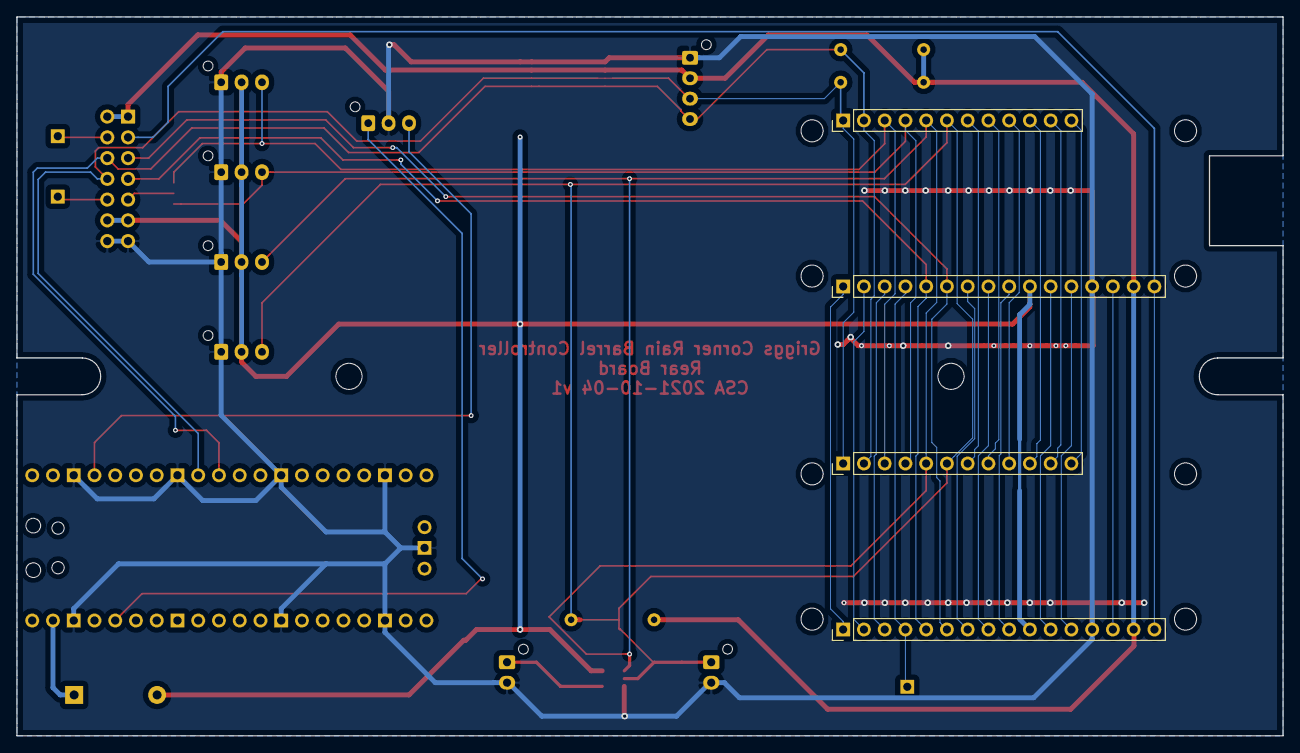
[picture p18: board Transflective.kicad_pcb from below]

Board: 2 copper layers, 155.0 x 88.0 mm, 26 parts (4 on the bottom side), 35 nets.
