cscott/rain-barrel/Transflective/LCD-Fixup/LCD-Fixup.kicad_pcb

## KiCad design Transflective/LCD-Fixup/LCD-Fixup.kicad_pcb (2022-03-22)

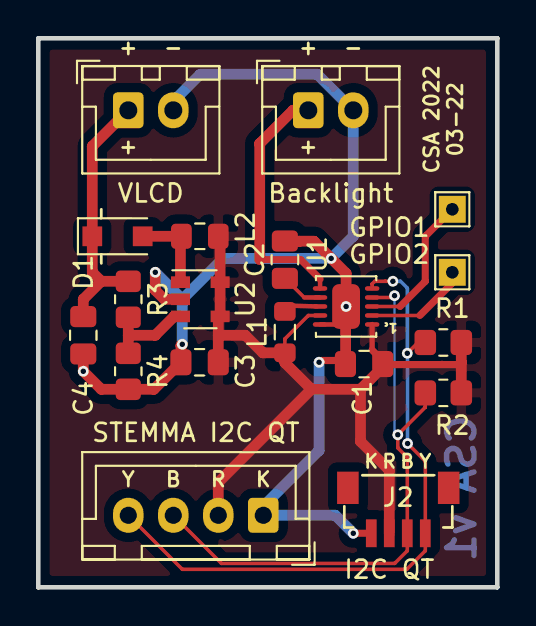
[picture p19: board LCD-Fixup.kicad_pcb from above]

Board: 2 copper layers, 25.5 x 30.5 mm, 19 parts (0 on the bottom side), 12 nets.

Parts:
C1, C2: 10uF; C_0805_2012Metric_Pad1.18x1.45mm_HandSolder
C3, C4: 1uF; C_0805_2012Metric_Pad1.18x1.45mm_HandSolder
D1: 1N5819; D_SOD-123F
J1: STEMMA I2C QT; JST_XH_B4B-XH-A_1x04_P2.50mm_Vertical
J2: I2C QT; JST-SH-4-VERT-SMD
J3: Backlight; JST_XH_B2B-XH-A_1x02_P2.50mm_Vertical
J4: VLCD; JST_XH_B2B-XH-A_1x02_P2.50mm_Vertical
L1: 1.0uH; L_0805_2012Metric_Pad1.05x1.20mm_HandSolder
L2: 10uH; L_0805_2012Metric_Pad1.15x1.40mm_HandSolder
R1, R2: 10k; R_0805_2012Metric_Pad1.20x1.40mm_HandSolder
R3: 59k; R_0805_2012Metric_Pad1.20x1.40mm_HandSolder
R4: 4.7k; R_0805_2012Metric_Pad1.20x1.40mm_HandSolder
TP1: GPIO1; TestPoint_THTPad_1.5x1.5mm_Drill0.7mm
TP2: GPIO2; TestPoint_THTPad_1.5x1.5mm_Drill0.7mm
U1: ADP1650ACPZ-R7
U2: AP3012; SOT-23-5

Connections:
+3V3: C1.1, C3.1, J1.2, J2.2, L1.1, L2.1, R1.1, R2.1, U1.1, U1.9, U2.4, U2.5
/CAP_CLK: J1.4, J2.4, R1.2, U1.5
/CAP_DAT: J1.3, J2.3, R2.2, U1.4
/GPIO1: TP1.1, U1.3
/GPIO2: TP2.1, U1.2
GND: C1.2, C2.2, C3.2, C4.2, J1.1, J2.1, J3.2, J4.2, R4.2, U1.10, U1.11, U2.2
unnamed: C2.1, U1.7
unnamed: D1.2, L2.2, U2.1
unnamed: J3.1, U1.6
unnamed: L1.2, U1.8
unnamed: R3.2, R4.1, U2.3
Vdrive: C4.1, D1.1, J4.1, R3.1
