cscott/rain-barrel/Transflective/LCD-Tester/LCD-Tester.kicad_pcb

## KiCad design Transflective/LCD-Tester/LCD-Tester.kicad_pcb (2022-02-04)

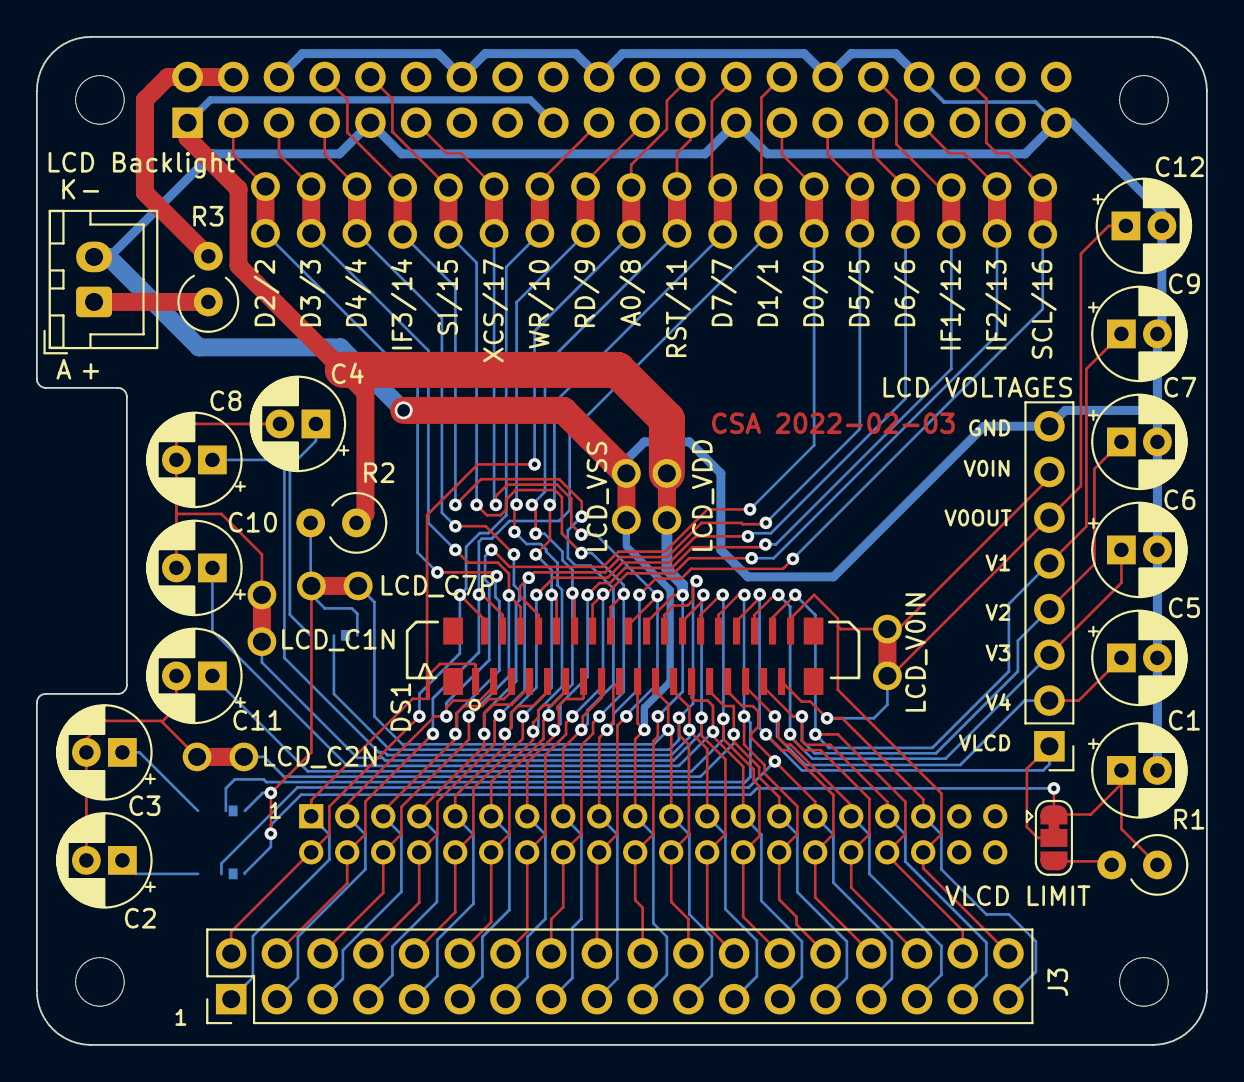
[picture p20: board LCD-Tester.kicad_pcb from above]

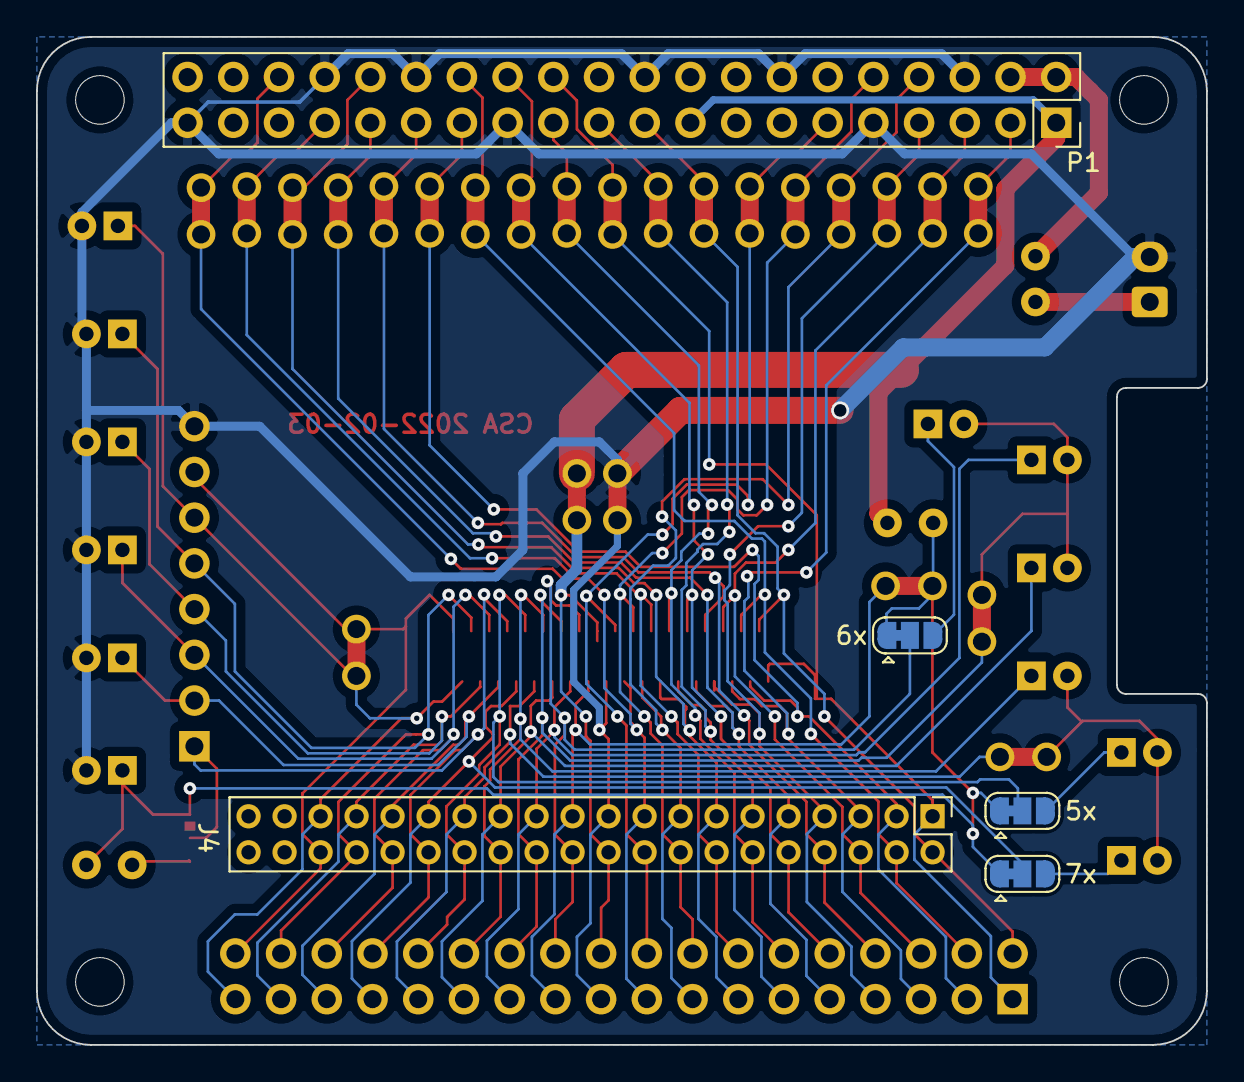
[picture p21: board LCD-Tester.kicad_pcb from below]

Board: 2 copper layers, 65.0 x 56.0 mm, 53 parts (5 on the bottom side), 65 nets.

Parts:
C1, C2, C3, C4, C5, C6, C7, C8, C9, C10, C11, C12: 1uF; CP_Radial_D5.0mm_P2.00mm
DS1: DISPLAYTECH-128240D; F314-1A7H1-11036
J1: LCD VOLTAGES; PinHeader_1x08_P2.54mm_Vertical
J2: LCD Backlight; JST_XH_B2B-XH-A_1x02_P2.50mm_Vertical
J3: Conn_01x36_Male; PinHeader_2x18_P2.54mm_Vertical
J4: Conn_01x36_Male; PinHeader_2x20_P2.00mm_Vertical
JP1: D2/2; Jumper-THT-NC
JP2: D3/3; Jumper-THT-NC
JP3: D4/4; Jumper-THT-NC
JP4: XCS/17; Jumper-THT-NC
JP5: WR/10; Jumper-THT-NC
JP6: RD/9; Jumper-THT-NC
JP7: RST/11; Jumper-THT-NC
JP8: D0/0; Jumper-THT-NC
JP9: D5/5; Jumper-THT-NC
JP10: D6/6; Jumper-THT-NC
JP11: IF2/13; Jumper-THT-NC
JP12: IF3/14; Jumper-THT-NC
JP13: SI/15; Jumper-THT-NC
JP14: A0/8; Jumper-THT-NC
JP15: D7/7; Jumper-THT-NC
JP16: D1/1; Jumper-THT-NC
JP17: IF1/12; Jumper-THT-NC
JP18: SCL/16; Jumper-THT-NC
JP19: VLCD LIMIT; SolderJumper-3_P1.3mm_Bridged12_RoundedPad1.0x1.5mm
JP20: 7x; SolderJumper-3_P1.3mm_Bridged12_RoundedPad1.0x1.5mm
JP21: 5x; SolderJumper-3_P1.3mm_Bridged12_RoundedPad1.0x1.5mm
JP22: 6x; SolderJumper-3_P1.3mm_Bridged12_RoundedPad1.0x1.5mm
JP23: LCD_V0IN; Jumper-THT-NC
JP24: LCD_C7P; Jumper-THT-NC
JP25: LCD_C1N; Jumper-THT-NC
JP26: LCD_C2N; Jumper-THT-NC
JP27: LCD_VDD; Jumper-THT-NC
JP28: LCD_VSS; Jumper-THT-NC
MK1, MK2, MK3, MK4: M2.5; MountingHole_2.7mm_M2.5
P1: Conn_02x20_Odd_Even; PinSocket_2x20_P2.54mm_Vertical
R1: 200; R_Axial_DIN0309_L9.0mm_D3.2mm_P2.54mm_Vertical
R2: 1M; R_Axial_DIN0309_L9.0mm_D3.2mm_P2.54mm_Vertical
R3: 15; R_Axial_DIN0309_L9.0mm_D3.2mm_P2.54mm_Vertical

Connections:
+3V3: JP27.1, P1.1, P1.17, R2.1
+5V: P1.2, P1.4, R3.2
/GPIO0: JP8.2, P1.27
/GPIO1: JP16.1, P1.28
/GPIO2: JP1.2, P1.3
/GPIO3: JP2.2, P1.5
/GPIO4: JP3.2, P1.7
/GPIO5: JP9.2, P1.29
/GPIO6: JP10.2, P1.31
/GPIO7: JP15.1, P1.26
/GPIO8: JP14.1, P1.24
/GPIO9: JP6.2, P1.21
/GPIO10: JP5.2, P1.19
/GPIO11: JP7.2, P1.23
/GPIO12: JP17.1, P1.32
/GPIO13: JP11.2, P1.33
/GPIO14: JP12.1, P1.8
/GPIO15: JP13.1, P1.10
/GPIO16: JP18.1, P1.36
/GPIO17: JP4.2, P1.11
/LCD_A0: DS1.1, J3.1, J4.1, JP14.2
/LCD_BACKLIGHT_A: J2.1, R3.1
/LCD_C1N: DS1.24, J3.24, J4.24, JP25.2
/LCD_C1P: C10.1, DS1.25, J3.25, J4.25
/LCD_C2N: DS1.27, J3.27, J4.27, JP26.2
/LCD_C2P: C11.1, DS1.26, J3.26, J4.26
/LCD_C3P: C8.1, DS1.23, J3.23, J4.23
/LCD_C4P: DS1.28, J3.28, J4.28, JP21.2
/LCD_C5P: DS1.22, J3.22, J4.22, JP22.2
/LCD_C6P: DS1.29, J3.29, J4.29, JP20.2
/LCD_C7P: DS1.21, J3.21, J4.21, JP24.2
/LCD_D0: DS1.3, J3.3, J4.3, JP8.1
/LCD_D1: DS1.4, J3.4, J4.4, JP16.2
/LCD_D2: DS1.5, J3.5, J4.5, JP1.1
/LCD_D3: DS1.6, J3.6, J4.6, JP2.1
/LCD_D4: DS1.7, J3.7, J4.7, JP3.1
/LCD_D5: DS1.8, J3.8, J4.8, JP9.1
/LCD_D6: DS1.9, J3.9, J4.9, JP10.1
/LCD_D7: DS1.10, J3.10, J4.10, JP15.2
/LCD_ERD: DS1.11, J3.11, J4.11, JP6.1
/LCD_IF1: DS1.13, J3.13, J4.13, JP17.2
/LCD_IF2: DS1.14, J3.14, J4.14, JP11.1
/LCD_IF3: DS1.15, J3.15, J4.15, JP12.2
/LCD_RST: DS1.12, J3.12, J4.12, JP7.1
/LCD_RWWR: DS1.2, J3.2, J4.2, JP5.1
/LCD_SCL: DS1.17, J3.17, J4.17, JP18.2
/LCD_SI: DS1.16, J3.16, J4.16, JP13.2
/LCD_V0IN: DS1.36, J1.7, J3.36, J4.36, JP23.2
/LCD_V0OUT: C12.1, DS1.35, J1.6, J3.35, J4.35, JP23.1
/LCD_V1: C9.1, DS1.34, J1.5, J3.34, J4.34
/LCD_V2: C7.1, DS1.33, J1.4, J3.33, J4.33
/LCD_V3: C6.1, DS1.32, J1.3, J3.32, J4.32
/LCD_V4: C5.1, DS1.31, J1.2, J3.31, J4.31
/LCD_VDD: DS1.20, J3.20, J4.20, JP27.2
/LCD_VLCD: DS1.30, J1.1, J3.30, J4.30, JP19.2
/LCD_VSS: DS1.19, J3.19, J4.19, JP28.2
/LCD_XCS: DS1.18, J3.18, J4.18, JP4.1
/VLCD: C1.1, JP19.1, JP20.1, JP21.1, JP22.1, JP24.1, R1.1, R2.2
GND: C1.2, C5.2, C6.2, C7.2, C9.2, C12.2, J1.8, J2.2, JP28.1, P1.6, P1.9, P1.14, P1.20, P1.25, P1.30, P1.34, P1.39
unnamed: C2.1, JP20.3
unnamed: C3.1, JP21.3
unnamed: C4.1, JP22.3
unnamed: C4.2, C8.2, C10.2, JP25.1
unnamed: C2.2, C3.2, C11.2, JP26.1
unnamed: JP19.3, R1.2
