cscott/rain-barrel/Transflective/LCD-Panel/LCD-panel.kicad_pcb

## KiCad design Transflective/LCD-Panel/LCD-panel.kicad_pcb (2021-10-04)

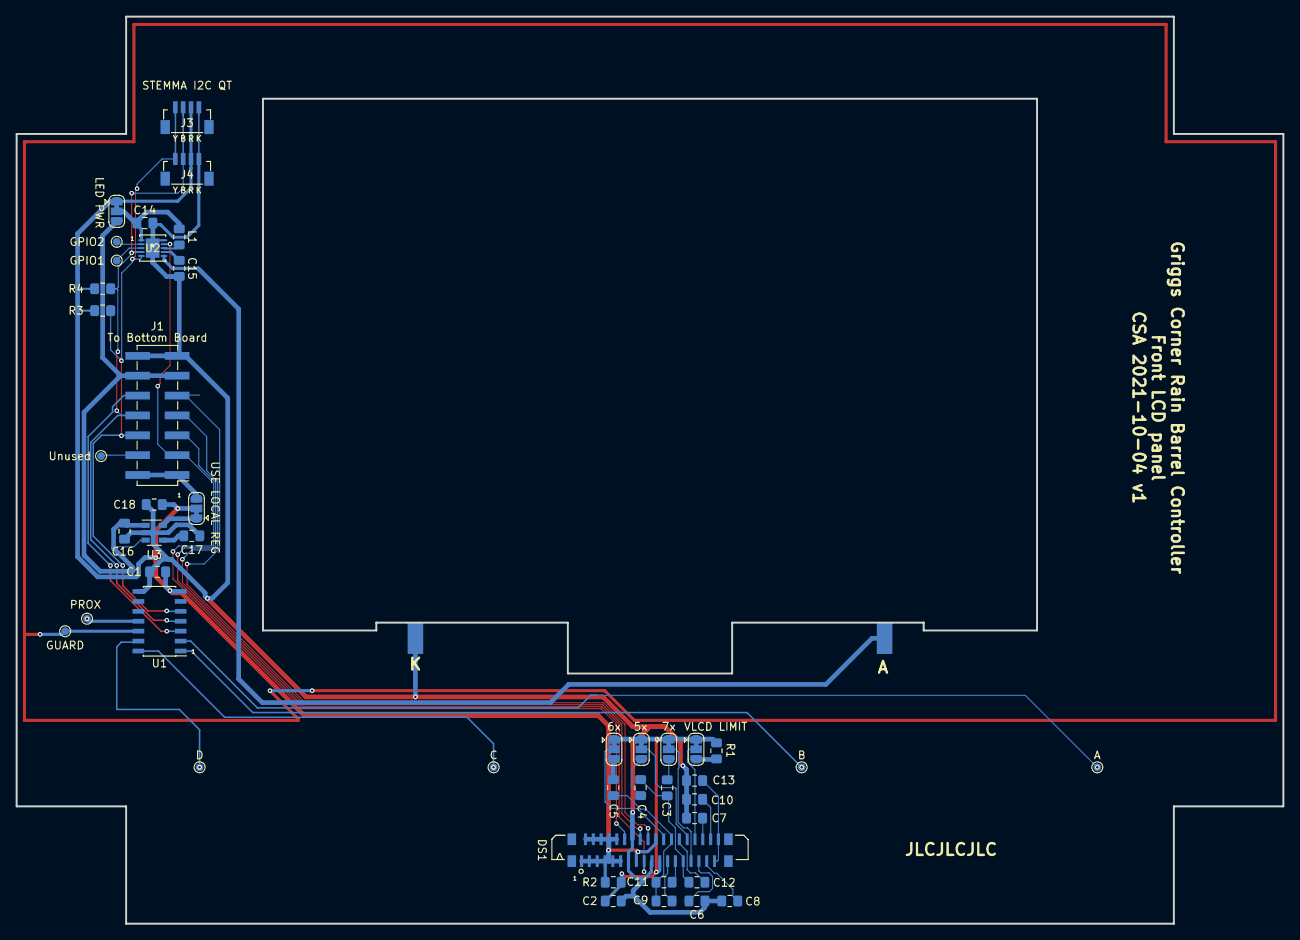
[picture p22: board LCD-panel.kicad_pcb from below]

Board: 2 copper layers, 162.0 x 116.0 mm, 46 parts (45 on the bottom side), 45 nets.

Parts:
C1, C16: .1uF; C_0805_2012Metric_Pad1.15x1.40mm_HandSolder
C2, C3, C4, C5, C6, C7, C8, C9, C10, C11, C12, C13, C18: 1uF; C_0805_2012Metric_Pad1.15x1.40mm_HandSolder
C14, C15: 10uF; C_0805_2012Metric_Pad1.15x1.40mm_HandSolder
C17: .01uF; C_0805_2012Metric_Pad1.15x1.40mm_HandSolder
DS1: DISPLAYTECH-128240D; F314-1A7H1-11036
J1: To Bottom Board; PinHeader_2x07_P2.54mm_Vertical_SMD
J2: DS BACKLIGHT; DisplayBacklight
J3, J4: STEMMA I2C QT; JST-SH-4-VERT-SMD
JP1: VLCD LIMIT; SolderJumper-3_P1.3mm_Bridged12_RoundedPad1.0x1.5mm
JP2: 7x; SolderJumper-3_P1.3mm_Bridged12_RoundedPad1.0x1.5mm
JP3: 5x; SolderJumper-3_P1.3mm_Bridged12_RoundedPad1.0x1.5mm
JP4: 6x; SolderJumper-3_P1.3mm_Bridged12_RoundedPad1.0x1.5mm
JP5: LED PWR; SolderJumper-3_P1.3mm_Bridged12_RoundedPad1.0x1.5mm
JP6: USE LOCAL REG; SolderJumper-3_P1.3mm_Bridged12_RoundedPad1.0x1.5mm
L1: 1.0uH; L_0805_2012Metric_Pad1.15x1.40mm_HandSolder
R1: 200; R_0805_2012Metric_Pad1.15x1.40mm_HandSolder
R2: 1M; R_0805_2012Metric_Pad1.15x1.40mm_HandSolder
R3, R4: 10k; R_0805_2012Metric_Pad1.15x1.40mm_HandSolder
TP1: GUARD; TestPoint_Pad_D1.0mm
TP2: A; TestPoint_Pad_D1.0mm
TP3: B; TestPoint_Pad_D1.0mm
TP4: C; TestPoint_Pad_D1.0mm
TP5: D; TestPoint_Pad_D1.0mm
TP6: PROX; TestPoint_Pad_D1.0mm
TP7: GPIO1; TestPoint_Pad_D1.0mm
TP8: GPIO2; TestPoint_Pad_D1.0mm
TP9: Unused; TestPoint_Pad_D1.0mm
U1: CAP1298; SOIC-14_3.9x8.7mm_P1.27mm
U2: ADP1650ACPZ-R7
U3: AP131-33; SOT-23-5

Connections:
+3V3: C1.1, C18.1, DS1.1, DS1.2, DS1.3, DS1.4, DS1.5, DS1.6, DS1.7, DS1.8, DS1.9, DS1.10, DS1.11, DS1.15, DS1.20, J3.2, J4.2, JP5.1, JP6.2, R2.1, R3.1, R4.1, U1.7
+5V: C16.1, J1.11, J1.12, JP5.3, U3.1, U3.3
/BUTTON_A: TP2.1, U1.2
/BUTTON_B: TP3.1, U1.1
/BUTTON_C: TP4.1, U1.14
/BUTTON_D: TP5.1, U1.13
/BUTTON_PROX: TP6.1, U1.11
/CAP_ALERT: J1.10, U1.3
/CAP_CLK: J1.6, J3.4, J4.4, R3.2, U1.5, U2.5
/CAP_DAT: J1.8, J3.3, J4.3, R4.2, U1.4, U2.4
/CAP_GUARD: TP1.1, U1.12
/DS_A: J2.A, U2.6
/DS_CLK: DS1.17, J1.5
/DS_CS: DS1.18, J1.9
/DS_DAT: DS1.16, J1.7
/DS_RST: DS1.12, J1.3, U2.9
/VLCD: C2.1, DS1.21, JP1.1, JP2.1, JP3.1, JP4.1, R1.1, R2.2
GND: C1.2, C2.2, C6.2, C7.2, C8.2, C10.2, C13.2, C14.2, C15.2, C16.2, C17.2, C18.2, DS1.13, DS1.14, DS1.19, J1.13, J1.14, J2.K, J3.1, J4.1, U1.8, U2.10, U2.11, U3.2
unnamed: C3.1, JP2.3
unnamed: C4.1, JP3.3
unnamed: C5.1, JP4.3
unnamed: C6.1, DS1.31
unnamed: C7.1, DS1.32
unnamed: C8.1, DS1.33
unnamed: C9.1, DS1.23
unnamed: C10.1, DS1.34
unnamed: C11.1, DS1.25
unnamed: C5.2, C9.2, C11.2, DS1.24
unnamed: C12.1, DS1.26
unnamed: C3.2, C4.2, C12.2, DS1.27
unnamed: C13.1, DS1.35, DS1.36
unnamed: C14.1, JP5.2, L1.1, U2.1
unnamed: C15.1, U2.7
unnamed: C17.1, U3.4
unnamed: DS1.22, JP4.2
unnamed: DS1.28, JP3.2
unnamed: DS1.29, JP2.2
unnamed: DS1.30, JP1.2
unnamed: J1.1, J1.2, JP6.3
unnamed: J1.4, TP9.1
unnamed: JP1.3, R1.2
unnamed: JP6.1, U3.5
unnamed: L1.2, U2.8
unnamed: TP7.1, U2.3
unnamed: TP8.1, U2.2
