cscott/rain-barrel/esp32-rainbarrel/src/flowtester.cpp

// This file is used to test the flowmeter as well as the smrty snitch
#if defined(FLOW_TESTER) || defined(SNITCH_TESTER)
#include "Arduino.h"
#include <Wire.h>
#include <AsyncDelay.h>
#include "flowmeter.h"
#ifdef SNITCH_TESTER
# include "smrtysnitch.h"
# include "smrty_decode.h"
#endif

#include <ESP8266WiFi.h>
#include <WiFiClient.h>
#include <ESP8266mDNS.h>
#include <ArduinoOTA.h>

// includes for OLED display
#include <SPI.h>
#include <Wire.h>
#include <Adafruit_GFX.h>
#include <Adafruit_SH110X.h>

#include "config.h"
#define MDNS_NAME "flowtester"

// Configuration of OLED display
Adafruit_SH1107 display = Adafruit_SH1107(64, 128, &Wire);

// OLED FeatherWing buttons map to different pins depending on board:
#define BUTTON_A  0
#define BUTTON_B 16
#define BUTTON_C  2

// Other config
#define LED_GPIO 0
#define LED_OFF 1 // active low
#define LED_ON  0 // active low

AsyncDelay updateDelay = AsyncDelay(250, AsyncDelay::MILLIS);
bool blinkWasOn = false;
bool mdns_success;

void normalText() {
  display.setTextColor(SH110X_WHITE, SH110X_BLACK);
}
void invertText() {
  display.setTextColor(SH110X_BLACK, SH110X_WHITE);
}
void maybeInvertText(bool maybe) {
  if (maybe) invertText(); else normalText();
}

void setup() {
  Wire.begin();
  Serial.begin(115200);

  // Wifi Setup
  WiFi.mode(WIFI_STA);
  WiFi.begin(WIFI_SSID, WIFI_PASS);

  // OLED setup
  display.begin(0x3C, true); // Address 0x3C default
  pinMode(BUTTON_A, INPUT_PULLUP);
  pinMode(BUTTON_B, INPUT_PULLUP);
  pinMode(BUTTON_C, INPUT_PULLUP);

  // Clear the buffer.
  display.clearDisplay();
  display.setRotation(1);

  display.setTextSize(1);
  display.setCursor(0,0);

  invertText();
#ifdef SNITCH_TESTER
  display.println("SMRT-Y snitch tester");
#else
  display.println("Flow meter tester");
#endif
  normalText();

  display.println("");
  display.print("Connecting to SSID\n" WIFI_SSID ": ");
  display.display();

  // Wait for connection
  while (WiFi.status() != WL_CONNECTED) {
    delay(500);
    Serial.print(".");
  }
  display.clearDisplay();
  display.setCursor(0,0);
  display.print("IP: ");
  display.println(WiFi.localIP());
  display.display();

  Serial.println("");
  Serial.print("Connected to ");
  Serial.println(WIFI_SSID);
  Serial.print("IP address: ");
  Serial.println(WiFi.localIP());

  mdns_success = false;
  if (MDNS.begin(MDNS_NAME)) {
    mdns_success = true;
    Serial.println("MDNS responder started: " MDNS_NAME);
    display.println("mDNS: " MDNS_NAME);
    display.display();
  }

  // Hostname defaults to esp3232-[MAC]
  ArduinoOTA.setHostname(MDNS_NAME);
  ArduinoOTA.setPassword(OTA_PASSWD);
  ArduinoOTA
  .onStart([]() {
    String type;
    digitalWrite(LED_BUILTIN, LOW);
    if (ArduinoOTA.getCommand() == U_FLASH)
      type = "sketch";
    else // U_SPIFFS
      type = "filesystem";

    // NOTE: if updating SPIFFS this would be the place to unmount SPIFFS using SPIFFS.end()
    Serial.println("Start updating " + type);
  });
  ArduinoOTA.onEnd([]() {
    Serial.println("\nEnd");
  });
  ArduinoOTA.onProgress([](unsigned int progress, unsigned int total) {
    Serial.printf("Progress: %u%%\r", (progress / (total / 100)));
  });
  ArduinoOTA.onError([](ota_error_t error) {
    Serial.printf("Error[%u]: ", error);
    if (error == OTA_AUTH_ERROR) Serial.println("Auth Failed");
    else if (error == OTA_BEGIN_ERROR) Serial.println("Begin Failed");
    else if (error == OTA_CONNECT_ERROR) Serial.println("Connect Failed");
    else if (error == OTA_RECEIVE_ERROR) Serial.println("Receive Failed");
    else if (error == OTA_END_ERROR) Serial.println("End Failed");
  });

  ArduinoOTA.begin();
}

void printHex(uint8_t num) {
    char buf[3];
    snprintf(buf, sizeof(buf), "%02X", (int)num);
    display.print(buf);
}

void updateDisplay(
#ifdef SNITCH_TESTER
                   uint8_t *buf, bool goodComm
#else
                   uint64_t count, uint8_t nBytes
#endif
) {
  display.clearDisplay();
  display.setCursor(0,0);
  display.setTextSize(1);
  invertText();
#ifdef SNITCH_TESTER
  display.println("SMRT-Y snitch tester");
#else
  display.println("Flow meter tester");
#endif
  normalText();
  display.print("IP: ");
  display.println(WiFi.localIP());
  if (mdns_success) {
      display.println("mDNS: " MDNS_NAME);
  }
#ifdef SNITCH_TESTER
  display.print("S#");
  display.print(SNITCH_OFFSET);
  display.print(" Seq ");
  printHex(buf[0]);
  display.print(" ");
  printHex(buf[9]);
  display.print(" ");
  printHex(buf[18]);
  if (goodComm) {
      display.print(blinkWasOn ? "" : " .");
      blinkWasOn = !blinkWasOn;
  } else {
      display.print(" X");
  }
  display.println();

  for (int i=0; i<3; i++) {
      for (int j=0; j<8; j++) {
          if (j==1||j==4||j==6) { display.print(" "); }
          printHex(buf[9*i + j + 1]);
      }
      // verify checksum
      uint8_t checksum=0;
      for (int j=0; j<7; j++) {
          checksum += buf[9*i + j + 1];
      }
      if (checksum != buf[9*i + 7 + 1]) {
          display.print("*");
      }
      display.println();
  }
#else
  display.setTextSize(1);
  display.print("F#");
  display.print(FLOWMETER_OFFSET);
  display.print(": ");
  display.print(count);
  display.print(" (");
  display.print(nBytes);
  display.println(")");
#endif
  display.display();
}

void loop() {
    ArduinoOTA.handle();
    MDNS.update();
    if (!updateDelay.isExpired()) {
        return;
    }
    updateDelay.restart();

#ifdef SNITCH_TESTER
# ifndef SNITCH_OFFSET
#  error SNITCH_OFFSET must be defined (is this testing snitch #1 or #2?)
# endif
    uint8_t buf[9*3];
    uint8_t status;
    bool goodComm = true;
    memset(buf, 0xFF, sizeof(buf));
    for (uint8_t i=0; i<3; i++) {
        Wire.beginTransmission(SNITCH_I2C_ADDR_BASE + SNITCH_OFFSET);
        Wire.write(i);
        status = Wire.endTransmission();
        if (status != 0) {
            goodComm = false;
            break; // no response from client, it must be disconnected
        }
        uint8_t reg, nBytes;
        do {
            nBytes = Wire.requestFrom(SNITCH_I2C_ADDR_BASE + SNITCH_OFFSET, 10);
            if (nBytes == 0) { goodComm = false; break; /* unexpected! */ }
            reg = Wire.read();
        } while (reg != i);  // busy loop until reg. write is done
        for (int j=0; Wire.available() && j<9; j++) {
            buf[(9*i)+j] = Wire.read();
        }
    }
    updateDisplay(buf, goodComm);
#else
# ifndef FLOWMETER_OFFSET
#  error FLOWMETER_OFFSET must be defined (is this testing flowmeter #1, #2, or #3?)
# endif

    Wire.requestFrom(FLOWMETER_I2C_ADDR_BASE + FLOWMETER_OFFSET, 8);
    uint64_t count = 0;
    int i;
    for (i=0; Wire.available(); i++) {
        count |= ((uint64_t)Wire.read()) << (8*i);
    }
    updateDisplay(count, i);
#endif
}

#endif /* FLOW_TESTER || SNITCH_TESTER */
