cscott/rain-barrel/esp32-rainbarrel/include/icons.h

// Converted using http://javl.github.io/image2cpp/

// 'leftarrow', 19x14px
#define LEFT_ARROW_NUM 1
#define LEFT_ARROW_WIDTH 19
#define LEFT_ARROW_HEIGHT 14
const unsigned char LightBitmap1 [] PROGMEM = {
  0x07, 0xe7, 0xe0, 0x0f, 0xcf, 0xe0, 0x1f, 0x9f, 0xc0, 0x3f, 0x3f, 0x80, 0x7f, 0x3f, 0x00, 0xfe, 
  0x7e, 0x00, 0xfc, 0xfc, 0x00, 0xfc, 0xfc, 0x00, 0x7e, 0x7e, 0x00, 0x3f, 0x3f, 0x00, 0x3f, 0x9f, 
  0x80, 0x1f, 0xcf, 0xc0, 0x0f, 0xcf, 0xe0, 0x07, 0xe7, 0xe0
};
// 'rightarrow', 19x14px
#define RIGHT_ARROW_NUM 2
#define RIGHT_ARROW_WIDTH 19
#define RIGHT_ARROW_HEIGHT 14
const unsigned char LightBitmap2 [] PROGMEM = {
  0xf8, 0xfc, 0x00, 0xfc, 0xfe, 0x00, 0x7e, 0x7e, 0x00, 0x3f, 0x3f, 0x00, 0x1f, 0x9f, 0x80, 0x0f, 
  0xcf, 0xc0, 0x07, 0xe7, 0xe0, 0x0f, 0xe7, 0xe0, 0x1f, 0xcf, 0xc0, 0x3f, 0x9f, 0x80, 0x3f, 0x3f, 
  0x00, 0x7e, 0x7e, 0x00, 0xfc, 0xfc, 0x00, 0xf8, 0xf8, 0x00
};
// 'dropoff', 23x25px
#define DROP_OFF_NUM 3
#define DROP_OFF_WIDTH 23
#define DROP_OFF_HEIGHT 25
const unsigned char LightBitmap3 [] PROGMEM = {
  0x20, 0x00, 0x00, 0x70, 0x00, 0x00, 0xf8, 0x30, 0x00, 0x7c, 0x78, 0x00, 0x3e, 0xcc, 0x00, 0x1f, 
  0xcc, 0x00, 0x0f, 0x86, 0x00, 0x07, 0xc3, 0x00, 0x07, 0xe3, 0x00, 0x07, 0xf1, 0x80, 0x0c, 0xf8, 
  0xc0, 0x18, 0x7c, 0x60, 0x18, 0x3e, 0x60, 0x30, 0x1e, 0x20, 0x30, 0x1f, 0x30, 0x30, 0x0f, 0xb0, 
  0x30, 0x07, 0xf0, 0x30, 0x03, 0xf0, 0x10, 0x01, 0xf0, 0x18, 0x00, 0xf8, 0x0c, 0x00, 0xfc, 0x0e, 
  0x01, 0xfe, 0x07, 0x87, 0x1e, 0x01, 0xfe, 0x0e, 0x00, 0x00, 0x00
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
  0x1e, 0x00, 0x00, 0x00, 0x0f, 0x00, 0x00, 0x00, 0x07, 0x80, 0x00, 0x00, 0x03, 0xc0, 0x00, 0x00, 
  0x01, 0xe0, 0x00, 0x00, 0x00, 0xf0, 0x00, 0x00, 0x00, 0x7c, 0x00, 0x00, 0x00, 0x1e, 0x00, 0x00, 
  0x00, 0x0f, 0x00, 0x00, 0x00, 0x07, 0x80, 0x00, 0x00, 0x03, 0xc0, 0x00, 0x00, 0x01, 0xe0, 0x00, 
  0x00, 0x00, 0x70, 0x00, 0x00, 0x00, 0x3c, 0x00, 0x00, 0x00, 0x1e, 0x00, 0x00, 0x00, 0x0f, 0x00, 
  0x00, 0x00, 0x07, 0x80, 0x00, 0x00, 0x03, 0xc0, 0x00, 0x00, 0x01, 0xc0, 0x00, 0x00, 0x00, 0x00
};
// 'connon', 29x24px
const unsigned char BlackBitmap6 [] PROGMEM = {
  0x00, 0x00, 0x00, 0x00, 0x00, 0x00, 0x00, 0x00, 0x00, 0x0f, 0x80, 0x00, 0x00, 0xff, 0xf8, 0x00, 
  0x03, 0xff, 0xfe, 0x00, 0x0f, 0xf8, 0xff, 0x80, 0x1f, 0x80, 0x0f, 0xc0, 0x3e, 0x00, 0x03, 0xe0, 
  0x7c, 0x00, 0x01, 0xf0, 0x78, 0x0f, 0xc0, 0x70, 0x70, 0x7f, 0xf0, 0x20, 0x00, 0xff, 0xf8, 0x00, 
  0x01, 0xff, 0xfe, 0x00, 0x03, 0xe0, 0x3e, 0x00, 0x03, 0xc0, 0x1e, 0x00, 0x03, 0x80, 0x06, 0x00, 
  0x00, 0x00, 0x00, 0x00, 0x00, 0x07, 0x00, 0x00, 0x00, 0x0f, 0x80, 0x00, 0x00, 0x0f, 0x80, 0x00, 
  0x00, 0x0f, 0x80, 0x00, 0x00, 0x0f, 0x80, 0x00, 0x00, 0x06, 0x00, 0x00, 0x00, 0x00, 0x00, 0x00
};
