cscott/rain-barrel/esp32-rainbarrel/include/bluebold-11px.h

const uint8_t bluebold11pt7bBitmaps[] PROGMEM = {
  0x00, 0xFF, 0xFF, 0xFF, 0xDE, 0xF7, 0xBC, 0xE4, 0x19, 0x06, 0x41, 0x33,
  0xFF, 0xFF, 0xCC, 0x83, 0x23, 0xFE, 0xFF, 0x99, 0x06, 0x41, 0xB0, 0x18,
  0x3E, 0xFE, 0xFA, 0xF8, 0x7E, 0x1F, 0x1B, 0x5F, 0xFE, 0x7C, 0x18, 0x62,
  0x4B, 0x25, 0x1C, 0x86, 0xC0, 0x40, 0x20, 0x32, 0x11, 0x99, 0x4C, 0xA4,
  0x30, 0x1E, 0x03, 0xF8, 0x1C, 0xE0, 0xE8, 0x07, 0x80, 0x1E, 0x30, 0xFB,
  0x8F, 0xFC, 0xE7, 0xE7, 0x1E, 0x3C, 0xF8, 0xFF, 0xC1, 0xE7, 0x80, 0xFD,
  0x80, 0x36, 0x64, 0xCC, 0xCC, 0xCC, 0xCC, 0x46, 0x63, 0xC6, 0x62, 0x33,
  0x33, 0x33, 0x33, 0x26, 0x6C, 0x0C, 0x23, 0x0C, 0xCD, 0xB6, 0x3F, 0x03,
  0x03, 0xF1, 0xB6, 0xCC, 0xC3, 0x00, 0xC0, 0x33, 0xFF, 0xCC, 0x30, 0xFD,
  0x80, 0xFF, 0xFC, 0x06, 0x08, 0x30, 0x60, 0xC3, 0x06, 0x0C, 0x30, 0x60,
  0xC3, 0x06, 0x0C, 0x30, 0x00, 0x3E, 0x3F, 0x98, 0xD8, 0x3C, 0x1E, 0x0F,
  0x07, 0x83, 0xC1, 0xB1, 0x9F, 0xC7, 0xC0, 0x3F, 0xF3, 0x33, 0x33, 0x33,
  0x33, 0x7D, 0xFD, 0x98, 0x30, 0x63, 0xCF, 0x3C, 0xF1, 0xC3, 0xFF, 0xF0,
  0x79, 0xF9, 0x30, 0x63, 0x87, 0x83, 0x83, 0x06, 0x8F, 0xF3, 0xE0, 0x0E,
  0x0E, 0x1E, 0x3E, 0x36, 0x66, 0xE6, 0xFF, 0xFF, 0x06, 0x06, 0x06, 0x7E,
  0x7E, 0x60, 0x60, 0x7C, 0xFE, 0x67, 0x03, 0x03, 0x47, 0xFE, 0x7C, 0x18,
  0x71, 0xC3, 0x0F, 0xDF, 0xB1, 0xE3, 0xC7, 0x8D, 0xF1, 0xC0, 0xFF, 0xFF,
  0x0E, 0x0E, 0x1C, 0x18, 0x18, 0x18, 0x30, 0x30, 0x30, 0x30, 0x3C, 0x7E,
  0x66, 0x66, 0x7C, 0x7E, 0xE7, 0xC3, 0xC3, 0xE7, 0x7E, 0x3C, 0x38, 0xFB,
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
  {   358,   7,  12,   8,    1,  -11 },   // 0x46 'F'
  {   369,  10,  12,  12,    1,  -11 },   // 0x47 'G'
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

const GFXfont bluebold11pt7b PROGMEM = {
  (uint8_t  *)bluebold11pt7bBitmaps,
  (GFXglyph *)bluebold11pt7bGlyphs,
  0x20, 0x7E, 20 };

// Approx. 1654 bytes
