cscott/rain-barrel/esp32-rainbarrel/include/bluebold-12px.h

const uint8_t bluebold12pt7bBitmaps[] PROGMEM = {
  0x00, 0xFF, 0xFF, 0xF3, 0xFC, 0xCF, 0x3C, 0xF3, 0xCF, 0x30, 0x0C, 0x81,
  0x30, 0x66, 0x0C, 0xC7, 0xFE, 0xFF, 0xC4, 0x41, 0x98, 0x33, 0x1F, 0xFB,
  0xFF, 0x13, 0x06, 0x60, 0xCC, 0x00, 0x18, 0x3C, 0x7F, 0xFE, 0xF8, 0xF8,
  0x7E, 0x1F, 0x1F, 0x9B, 0xFF, 0xFE, 0x3C, 0x18, 0x63, 0x24, 0xC9, 0x23,
  0xD8, 0x64, 0x03, 0x00, 0xC0, 0x20, 0x19, 0x86, 0xF1, 0x24, 0xC9, 0x31,
  0x80, 0x1F, 0x01, 0xFC, 0x1C, 0xE0, 0xE4, 0x07, 0x80, 0x1C, 0x00, 0xF1,
  0xC7, 0xCE, 0x7F, 0x67, 0x3F, 0x38, 0xF9, 0xE7, 0xCF, 0xFF, 0x3F, 0xF8,
  0x78, 0xE0, 0xFF, 0xB4, 0x39, 0x98, 0xC6, 0x63, 0x18, 0xC6, 0x31, 0x8C,
  0x31, 0x8C, 0x31, 0xC0, 0xE3, 0x0C, 0x63, 0x0C, 0x63, 0x18, 0xC6, 0x31,
  0x98, 0xC6, 0x67, 0x00, 0x0C, 0x03, 0x08, 0xC7, 0xB7, 0x7F, 0x8F, 0xC1,
  0xE0, 0xFC, 0x7F, 0xBB, 0x38, 0xC4, 0x30, 0x0C, 0x00, 0x30, 0xCF, 0xFF,
  0x30, 0xC0, 0xFF, 0xBC, 0xFF, 0xDF, 0xE0, 0x07, 0x06, 0x06, 0x0C, 0x0C,
  0x0C, 0x18, 0x18, 0x18, 0x38, 0x30, 0x30, 0x70, 0x60, 0x60, 0xE0, 0x1E,
  0x1F, 0xE6, 0x1B, 0x87, 0xC0, 0xF0, 0x3C, 0x0F, 0x03, 0xC0, 0xF8, 0x76,
  0x18, 0xFE, 0x1E, 0x00, 0x3F, 0xFF, 0x33, 0x33, 0x33, 0x33, 0x33, 0x3C,
  0x7E, 0xFF, 0x63, 0x43, 0x03, 0x0E, 0x3E, 0x7C, 0x70, 0xE0, 0xE0, 0xFF,
  0xFF, 0x3C, 0x7E, 0x26, 0x06, 0x06, 0x1C, 0x1E, 0x07, 0x03, 0x03, 0x63,
  0xFE, 0x3C, 0x0E, 0x0E, 0x1E, 0x1E, 0x3E, 0x76, 0x66, 0xE6, 0xF6, 0xFF,
  0xFF, 0x06, 0x06, 0x06, 0xFE, 0xFE, 0xE0, 0xC0, 0xFC, 0xFE, 0x67, 0x03,
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
  {   448,   7,  13,   9,    1,  -12 },   // 0x46 'F'
  {   460,  11,  15,  13,    1,  -13 },   // 0x47 'G'
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

const GFXfont bluebold12pt7b PROGMEM = {
  (uint8_t  *)bluebold12pt7bBitmaps,
  (GFXglyph *)bluebold12pt7bGlyphs,
  0x20, 0x7E, 22 };

// Approx. 1885 bytes
