cscott/rain-barrel/esp32-rainbarrel/include/bluebold-14px.h

const uint8_t bluebold14pt7bBitmaps[] PROGMEM = {
  0x00, 0xFF, 0xFF, 0xFF, 0xED, 0x6F, 0xF0, 0xEF, 0x9F, 0x3E, 0x7C, 0x58,
  0xB1, 0x00, 0x0C, 0x60, 0xCC, 0x0C, 0xC7, 0xFF, 0x7F, 0xF1, 0x98, 0x19,
  0x81, 0x98, 0x19, 0x8F, 0xFE, 0xFF, 0xE3, 0x30, 0x33, 0x02, 0x30, 0x63,
  0x00, 0x1C, 0x0F, 0x8F, 0xFB, 0xFE, 0xFD, 0x3F, 0x0F, 0xF1, 0xFE, 0x1F,
  0x87, 0x79, 0xFB, 0xFE, 0xFF, 0x0F, 0x81, 0xC0, 0x70, 0xCD, 0x98, 0x89,
  0x88, 0xB0, 0xFB, 0x07, 0x30, 0x06, 0x00, 0x60, 0x06, 0x00, 0xCE, 0x0D,
  0xF1, 0x91, 0x19, 0x11, 0x9B, 0x30, 0xE0, 0x1F, 0x00, 0x7F, 0x01, 0xFE,
  0x03, 0x9E, 0x07, 0x10, 0x0E, 0x00, 0x0E, 0x00, 0x1E, 0x1C, 0x3E, 0x78,
  0xFE, 0xE3, 0xFF, 0xC7, 0x3F, 0x8E, 0x3F, 0x1E, 0x7E, 0x1F, 0xFE, 0x3F,
  0xFE, 0x1E, 0x3E, 0xFF, 0xB4, 0x80, 0x39, 0x9C, 0xC6, 0x73, 0x18, 0xC6,
  0x31, 0x8C, 0x63, 0x8C, 0x63, 0x8C, 0x70, 0xE3, 0x1C, 0x63, 0x1C, 0x63,
  0x18, 0xC6, 0x31, 0x8C, 0xE6, 0x33, 0x99, 0xC0, 0x06, 0x00, 0x60, 0x46,
  0x26, 0x67, 0xF6, 0xE3, 0xFC, 0x0F, 0x00, 0xF0, 0x3F, 0xC7, 0x6E, 0xE6,
  0x74, 0x62, 0x06, 0x00, 0x60, 0x30, 0xCF, 0xFF, 0xFC, 0xC3, 0x0C, 0xFF,
  0xBC, 0xFF, 0xFE, 0xDF, 0xE0, 0x03, 0x81, 0x81, 0xC0, 0xC0, 0x60, 0x70,
  0x30, 0x18, 0x1C, 0x0C, 0x06, 0x07, 0x03, 0x01, 0x80, 0xC0, 0xE0, 0x60,
  0x70, 0x00, 0x1F, 0x83, 0xFC, 0x7F, 0xE7, 0x0E, 0xF0, 0xFE, 0x07, 0xE0,
  0x7E, 0x07, 0xE0, 0x7E, 0x07, 0xF0, 0xF7, 0x0E, 0x7F, 0xE3, 0xFC, 0x1F,
  0x80, 0x3F, 0xFF, 0xF3, 0x9C, 0xE7, 0x39, 0xCE, 0x73, 0x9C, 0xE0, 0x3F,
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
  {   577,   9,  15,  10,    1,  -14 },   // 0x46 'F'
  {   594,  12,  16,  14,    1,  -14 },   // 0x47 'G'
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

const GFXfont bluebold14pt7b PROGMEM = {
  (uint8_t  *)bluebold14pt7bBitmaps,
  (GFXglyph *)bluebold14pt7bGlyphs,
  0x20, 0x7E, 26 };

// Approx. 2226 bytes
