cscott/rain-barrel/esp32-rainbarrel/include/bluehigh-10px.h

const uint8_t bluehigh10pt7bBitmaps[] PROGMEM = {
  0x00, 0xFF, 0xFD, 0x3C, 0x99, 0x99, 0x90, 0x12, 0x12, 0x12, 0xFF, 0x24,
  0x24, 0x24, 0xFF, 0x48, 0x48, 0x48, 0x18, 0x3E, 0x7E, 0xD8, 0x78, 0x3E,
  0x1B, 0x1B, 0x7E, 0xFC, 0x18, 0xC4, 0xA4, 0xA8, 0xC8, 0x08, 0x10, 0x10,
  0x13, 0x25, 0x25, 0x23, 0x78, 0x3F, 0x0C, 0xC3, 0x00, 0x60, 0x1C, 0x0F,
  0xB3, 0x3C, 0xC7, 0x39, 0xCF, 0xF1, 0xE7, 0xF6, 0x69, 0x49, 0x24, 0x92,
  0x44, 0x98, 0xC9, 0x12, 0x49, 0x24, 0x94, 0xB0, 0x10, 0x10, 0x92, 0x55,
  0x38, 0x38, 0x54, 0x93, 0x10, 0x10, 0x4B, 0xF4, 0x80, 0xF8, 0xFC, 0xF0,
  0x0C, 0x20, 0x86, 0x10, 0x43, 0x08, 0x20, 0x84, 0x10, 0xC0, 0x3C, 0x7E,
  0xE3, 0xC3, 0xC3, 0xC3, 0xC3, 0xC3, 0x67, 0x7E, 0x3C, 0x7D, 0xB6, 0xDB,
  0x6D, 0x80, 0x7B, 0xF4, 0xC3, 0x0C, 0xE6, 0x30, 0xC3, 0xFF, 0xC0, 0x73,
  0xE9, 0x86, 0x71, 0xE0, 0xC3, 0x8F, 0xF7, 0x80, 0x0E, 0x0E, 0x16, 0x36,
  0x26, 0x46, 0xFF, 0xFF, 0x06, 0x06, 0x06, 0x7D, 0xFB, 0x07, 0xCF, 0xC8,
  0xC1, 0x83, 0x87, 0xF9, 0xE0, 0x18, 0xE7, 0x18, 0xDB, 0xFC, 0x71, 0xC5,
  0xF7, 0x80, 0xFF, 0xFC, 0x18, 0x60, 0x83, 0x06, 0x08, 0x30, 0x60, 0xC0,
  0x38, 0xF9, 0x32, 0x67, 0x8F, 0xB1, 0xE3, 0xC7, 0xFC, 0xF0, 0x7B, 0xEC,
  0xF3, 0xCF, 0xF6, 0xC6, 0x39, 0xC6, 0x00, 0xF0, 0x0F, 0xF0, 0x0F, 0xC0,
  0x08, 0x18, 0x3F, 0x7F, 0xFF, 0x3F, 0x18, 0x08, 0xFF, 0xF0, 0x3F, 0xFC,
  0x08, 0x0C, 0xFE, 0xFF, 0xFF, 0xFE, 0x0C, 0x08, 0x7B, 0xF8, 0xC3, 0x0C,
  0x63, 0x0C, 0x00, 0xC3, 0x00, 0x3C, 0x42, 0x99, 0x85, 0xBD, 0xA5, 0xA5,
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
  {   286,   6,  11,   7,    1,  -10 },   // 0x46 'F'
  {   295,   9,  11,  10,    1,  -10 },   // 0x47 'G'
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

const GFXfont bluehigh10pt7b PROGMEM = {
  (uint8_t  *)bluehigh10pt7bBitmaps,
  (GFXglyph *)bluehigh10pt7bGlyphs,
  0x20, 0x7E, 17 };

// Approx. 1456 bytes
