cscott/rain-barrel/esp32-rainbarrel/include/bluehigh-12px.h

const uint8_t bluehigh12pt7bBitmaps[] PROGMEM = {
  0x00, 0xFF, 0xFF, 0xCB, 0xC0, 0xCE, 0x73, 0x18, 0xC4, 0x09, 0x86, 0x47,
  0xFD, 0xFF, 0x11, 0x04, 0xC3, 0x20, 0x88, 0xFF, 0xBF, 0xE2, 0x21, 0x90,
  0x44, 0x00, 0x18, 0x3E, 0xFF, 0xDA, 0xD8, 0x7C, 0x3E, 0x1F, 0x1B, 0x9B,
  0xFE, 0x7C, 0x18, 0x61, 0x24, 0x89, 0x21, 0x98, 0x04, 0x01, 0x00, 0xC0,
  0x20, 0x08, 0x04, 0x61, 0x24, 0xC9, 0x21, 0x80, 0x7C, 0x1F, 0xC3, 0x38,
  0x64, 0x0C, 0x00, 0xC0, 0x0C, 0x77, 0xCE, 0xED, 0x98, 0xF3, 0x0E, 0x73,
  0xC7, 0xFC, 0xF1, 0xC0, 0xFD, 0x80, 0x36, 0x44, 0x88, 0x88, 0x88, 0x88,
  0xC4, 0x46, 0x30, 0xC6, 0x22, 0x31, 0x11, 0x11, 0x11, 0x32, 0x26, 0xC0,
  0x08, 0x04, 0x32, 0x6D, 0x63, 0xE0, 0x40, 0xF8, 0xD6, 0xC9, 0x84, 0x02,
  0x00, 0x30, 0xCF, 0xFF, 0x30, 0xC0, 0xFD, 0x80, 0xFF, 0xFC, 0x06, 0x0C,
  0x10, 0x60, 0xC1, 0x06, 0x0C, 0x10, 0x60, 0xC1, 0x02, 0x0C, 0x10, 0x60,
  0x1E, 0x1F, 0xE6, 0x1B, 0x87, 0xC0, 0xF0, 0x3C, 0x0F, 0x03, 0xC0, 0xF8,
  0x76, 0x18, 0xFE, 0x1E, 0x00, 0x3F, 0xF3, 0x33, 0x33, 0x33, 0x33, 0x30,
  0x3C, 0xFE, 0x43, 0x03, 0x03, 0x07, 0x1E, 0x38, 0x60, 0xC0, 0xC0, 0xFF,
  0xFF, 0x3C, 0x7E, 0x46, 0x06, 0x06, 0x1C, 0x1E, 0x07, 0x03, 0x03, 0x63,
  0xFE, 0x3C, 0x0E, 0x0E, 0x1E, 0x36, 0x36, 0x66, 0xE6, 0xC6, 0xFF, 0xFF,
  0x06, 0x06, 0x06, 0xFE, 0xFE, 0xC0, 0xC0, 0xFC, 0xFE, 0x47, 0x03, 0x03,
  0x03, 0x87, 0xFE, 0xFC, 0x0C, 0x3C, 0x30, 0x60, 0x5C, 0xFE, 0xE7, 0xC3,
  0xC3, 0xC3, 0xE7, 0x7E, 0x3C, 0xFF, 0xFF, 0x07, 0x06, 0x0C, 0x0C, 0x18,
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
  {   401,   7,  13,   9,    1,  -12 },   // 0x46 'F'
  {   413,  10,  13,  12,    1,  -12 },   // 0x47 'G'
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

const GFXfont bluehigh12pt7b PROGMEM = {
  (uint8_t  *)bluehigh12pt7bBitmaps,
  (GFXglyph *)bluehigh12pt7bGlyphs,
  0x20, 0x7E, 21 };

// Approx. 1762 bytes
