cscott/rain-barrel/esp32-rainbarrel/include/bluebold-16px.h

const uint8_t bluebold16pt7bBitmaps[] PROGMEM = {
  0xFF, 0xFF, 0xFF, 0xFF, 0xB5, 0xBF, 0xC0, 0xE7, 0xE7, 0xE7, 0x67, 0x67,
  0x67, 0x66, 0x62, 0x06, 0x30, 0x18, 0xC0, 0x63, 0x01, 0x9C, 0x7F, 0xFD,
  0xFF, 0xF7, 0xFF, 0xC3, 0x18, 0x1C, 0xE0, 0x63, 0x0F, 0xFF, 0xBF, 0xFE,
  0xFF, 0xF8, 0xE7, 0x03, 0x18, 0x0C, 0x60, 0x31, 0x80, 0x0E, 0x01, 0xC1,
  0xFF, 0x7F, 0xEF, 0xFD, 0xDC, 0x3F, 0x83, 0xFC, 0x3F, 0xC1, 0xFC, 0x3B,
  0x87, 0x77, 0xFF, 0xFF, 0xBF, 0xE0, 0x70, 0x0E, 0x00, 0x78, 0x63, 0xF3,
  0x8C, 0xCC, 0x33, 0x30, 0xFD, 0xC1, 0xE6, 0x03, 0x18, 0x00, 0xC0, 0x03,
  0x00, 0x1C, 0x00, 0x63, 0x01, 0x9E, 0x0E, 0xFC, 0x33, 0x31, 0xCC, 0xC6,
  0x3F, 0x38, 0x78, 0x0F, 0x80, 0x1F, 0xF0, 0x1F, 0xF8, 0x0F, 0x3C, 0x07,
  0x8C, 0x03, 0xC0, 0x00, 0xF0, 0x00, 0x7C, 0x00, 0x1F, 0x1E, 0x3F, 0xCF,
  0x1F, 0xF7, 0x9E, 0x7F, 0x8F, 0x1F, 0xC7, 0x87, 0xE3, 0xE3, 0xF0, 0xFF,
  0xFC, 0x3F, 0xFF, 0x07, 0xC7, 0xC0, 0xFF, 0xB4, 0x80, 0x1E, 0x38, 0xE1,
  0xC7, 0x0E, 0x1C, 0x70, 0xE1, 0xC3, 0x87, 0x0E, 0x1C, 0x38, 0x70, 0x70,
  0xE1, 0xC1, 0xC3, 0x83, 0x87, 0x80, 0xF0, 0xE0, 0xE1, 0xC1, 0xC3, 0x87,
  0x07, 0x0E, 0x1C, 0x38, 0x70, 0xE1, 0xC3, 0x87, 0x1C, 0x38, 0x71, 0xC3,
  0x8E, 0x3C, 0x00, 0x03, 0x00, 0x0C, 0x04, 0x31, 0x18, 0xC6, 0x73, 0x3C,
  0xFF, 0xC1, 0xFE, 0x01, 0xE0, 0x07, 0x80, 0x7F, 0x83, 0xF7, 0x3C, 0xCF,
  0x63, 0x19, 0x0C, 0x40, 0x30, 0x00, 0xC0, 0x38, 0x73, 0xFF, 0xFF, 0xE7,
  0x0E, 0x1C, 0xDF, 0xB5, 0x80, 0xFF, 0xFF, 0xC0, 0xDF, 0xE0, 0x01, 0xC0,
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
  {   739,  10,  17,  12,    2,  -16 },   // 0x46 'F'
  {   761,  14,  18,  16,    1,  -17 },   // 0x47 'G'
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

const GFXfont bluebold16pt7b PROGMEM = {
  (uint8_t  *)bluebold16pt7bBitmaps,
  (GFXglyph *)bluebold16pt7bGlyphs,
  0x20, 0x7E, 29 };

// Approx. 2677 bytes
