cscott/rain-barrel/esp32-rainbarrel/include/bluebold-18px.h

const uint8_t bluebold18pt7bBitmaps[] PROGMEM = {
  0xFF, 0xFF, 0xFF, 0xFF, 0xFF, 0xF7, 0x66, 0x00, 0x6F, 0xFF, 0x60, 0xE7,
  0xE7, 0xC7, 0xC7, 0xC7, 0xC7, 0xC7, 0xC7, 0xC6, 0x03, 0x0C, 0x03, 0x1C,
  0x03, 0x1C, 0x07, 0x18, 0x07, 0x18, 0x7F, 0xFF, 0x7F, 0xFF, 0x7F, 0xFF,
  0x0E, 0x30, 0x0E, 0x30, 0x0C, 0x30, 0x0C, 0x70, 0x0C, 0x70, 0xFF, 0xFE,
  0xFF, 0xFE, 0xFF, 0xFE, 0x18, 0xE0, 0x18, 0xE0, 0x38, 0xC0, 0x38, 0xC0,
  0x07, 0x80, 0x1E, 0x01, 0xFF, 0x1F, 0xFE, 0x7F, 0xF3, 0xFE, 0xC7, 0x78,
  0x1F, 0xE0, 0x7F, 0xE0, 0xFF, 0xC0, 0xFF, 0x81, 0xFE, 0x07, 0xBC, 0x1E,
  0xF7, 0x7F, 0x9F, 0xFE, 0x7F, 0xF2, 0xFF, 0x80, 0x78, 0x01, 0xE0, 0x38,
  0x38, 0x6C, 0x30, 0xC6, 0x70, 0xC6, 0x70, 0xEE, 0x60, 0xFE, 0xE0, 0x7C,
  0xC0, 0x11, 0xC0, 0x01, 0xC0, 0x01, 0x80, 0x03, 0x80, 0x03, 0x08, 0x07,
  0x3E, 0x07, 0x7F, 0x06, 0x63, 0x0E, 0x63, 0x0C, 0x63, 0x1C, 0x3E, 0x1C,
  0x1C, 0x0F, 0xC0, 0x07, 0xFC, 0x00, 0xFF, 0xC0, 0x3C, 0x78, 0x07, 0x8E,
  0x00, 0xF1, 0x00, 0x1F, 0x00, 0x01, 0xF0, 0x00, 0x3E, 0x00, 0x03, 0xE1,
  0xE0, 0xFE, 0x3C, 0x3F, 0xE7, 0x8F, 0xBF, 0xF1, 0xE3, 0xFE, 0x3C, 0x3F,
  0x87, 0x83, 0xF0, 0xF8, 0xFE, 0x0F, 0xFF, 0xE1, 0xFF, 0xFE, 0x1F, 0xF3,
  0xE0, 0xF8, 0x7E, 0x6F, 0xFF, 0x73, 0x64, 0x1E, 0x38, 0xF1, 0xC3, 0x8E,
  0x1C, 0x38, 0xE1, 0xC3, 0x87, 0x0E, 0x1C, 0x38, 0x70, 0xE1, 0xC1, 0xC3,
  0x87, 0x07, 0x0E, 0x1E, 0x1C, 0x3C, 0xE0, 0xE1, 0xE1, 0xC3, 0x83, 0x87,
  0x0E, 0x0E, 0x1C, 0x38, 0x70, 0xE1, 0xC3, 0x87, 0x0E, 0x1C, 0x70, 0xE1,
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
  {   973,  11,  20,  13,    1,  -19 },   // 0x46 'F'
  {  1001,  16,  21,  19,    1,  -19 },   // 0x47 'G'
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

const GFXfont bluebold18pt7b PROGMEM = {
  (uint8_t  *)bluebold18pt7bBitmaps,
  (GFXglyph *)bluebold18pt7bGlyphs,
  0x20, 0x7E, 33 };

// Approx. 3347 bytes
