cscott/rain-barrel/esp32-rainbarrel/include/smrtysnitch.h

#ifndef SMRTYSNITCH_H
#define SMRTYSNITCH_H

// Flowmeter is 0x08
// Motor Shield is 0x60 (selectable up to 0x6F)
// LIS3DH is 0x19
// OLED featherwing (for flowtester) is 0x3C

#define SNITCH_I2C_ADDR_BASE 0x24

#define SNITCH_BUFFER_SIZE 8

#endif
