cscott/rain-barrel/esp32-rainbarrel/include/adp1650.h

#define ADP1650_I2C_ADDR 0x30

#define ADP1650_REG_DESIGN_INFO 0x00
#define ADP1650_REG_VREF_TIMER  0x02
#define ADP1650_REG_CURRENT_SET 0x03
#define ADP1650_REG_OUTPUT_MODE 0x04
#define ADP1650_REG_FAULT_INFO  0x05
#define ADP1650_REG_INPUT_CTRL  0x06
#define ADP1650_REG_AD_MOD      0x07
#define ADP1650_REG_ADC         0x08
#define ADP1650_REG_BATT_LOW    0x09

/* current set register */
#define ADP1650_I_TOR_25MA  0x0
#define ADP1650_I_TOR_50MA  0x1
#define ADP1650_I_TOR_75MA  0x2
#define ADP1650_I_TOR_100MA 0x3
#define ADP1650_I_TOR_125MA 0x4
#define ADP1650_I_TOR_150MA 0x5
#define ADP1650_I_TOR_175MA 0x6
#define ADP1650_I_TOR_200MA 0x7

/* output mode register */
#define ADP1650_FREQ_FB   0x10
#define ADP1650_OUTPUT_EN 0x08
#define ADP1650_STR_MODE  0x04
#define ADP1650_LED_MOD_STANDBY 0x00
#define ADP1650_LED_MOD_5V_OUT  0x01
#define ADP1650_LED_MOD_ASSIST  0x02
#define ADP1650_LED_MOD_FLASH   0x03
