cscott/rain-barrel/esp32-rainbarrel/include/cap1298.h

#define CAP1298_I2C_ADDR 0x28

#define CAP1298_REG_MAIN_CONTROL   0x00
#define CAP1298_REG_GENERAL_STATUS 0x02
#define CAP1298_REG_SENSOR_STATUS  0x03
#define CAP1298_REG_NOISE_FLAG_STATUS 0x0A
#define CAP1298_REG_SENSOR_DELTA_COUNT(i) (0x10+i)
#define CAP1298_REG_SENSITIVITY_CONTROL 0x1F
#define CAP1298_REG_CONFIGURATION 0x20
#define CAP1298_REG_SENSOR_INPUT_ENABLE 0x21
#define CAP1298_REG_SENSOR_INPUT_CONFIG 0x22
#define CAP1298_REG_SENSOR_INPUT_CONFIG2 0x23
#define CAP1298_REG_SAMPLING_CONFIG 0x24
#define CAP1298_REG_CALIBRATION 0x26
#define CAP1298_REG_INT_ENABLE 0x27
#define CAP1298_REG_REPEAT_ENABLE 0x28
#define CAP1298_REG_SIGNAL_GUARD_ENABLE 0x29
#define CAP1298_REG_MULTI_TOUCH_CONFIG 0x2A
#define CAP1298_REG_MULTI_TOUCH_PATTERN_CONFIG 0x2B
#define CAP1298_REG_MULTI_TOUCH_PATTERN 0x2D
#define CAP1298_REG_BASE_COUNT_OOL 0x2E
#define CAP1298_REG_RECALIBRATION_CONFIG 0x2F
#define CAP1298_REG_SENSOR_THRESHOLD(i) (0x30+i)
#define CAP1298_REG_SENSOR_NOISE_THRESH 0x38
#define CAP1298_REG_STANDBY_CHANNEL 0x40
#define CAP1298_REG_STANDBY_CONFIG 0x41
#define CAP1298_REG_STANDBY_SENSITIVITY 0x42
#define CAP1298_REG_STANDBY_THRESH 0x43
#define CAP1298_REG_CONFIGURATION2 0x44
#define CAP1298_REG_SENSOR_BASE_COUNT(i) (0x50+i)
#define CAP1298_REG_POWER_BUTTON 0x60
#define CAP1298_REG_POWER_BUTTON_CONFIG 0x61
#define CAP1298_REG_CALIBRATION_SENSITIVITY1 0x80
#define CAP1298_REG_CALIBRATION_SENSITIVITY2 0x81
#define CAP1298_REG_SENSOR_INPUT_CALIBRATION(i) (0xB1+i)
#define CAP1298_REG_SENSOR_INPUT_CALIBRATION_LSB1 0xB9
#define CAP1298_REG_SENSOR_INPUT_CALIBRATION_LSB2 0xBA
#define CAP1298_REG_PRODUCT_ID 0xFD
#define CAP1298_REG_MANUFACTURER_ID 0xFE
#define CAP1298_REG_REVISION 0xFF
