cscott/rain-barrel/(commit log)

2021-06-01 Initial commit of working version of esp32 rainpump server
    [feather-top.stl, newtop.scad, standoff.scad]
2021-06-03 Add capacitive touch
    Unfortunately there seems to be a bug with the magtag hardware here.
    I2C device 0x5A is found, but the initialization fails. :(
    [esp32-rainbarrel.ino]
2021-06-03 Fritzing schematic for water level sensor amps
    [LevelAmps.fzz]
2021-06-03 Switch to alternate MPR121 driver for capacitive touch
    This version is hacky, but it actually works on the MagTag
2021-06-03 Add active rectifier to level amps to protect against negative inputs
    Ensure that if/when the water level sensor is disconnected, or for
    some reason the zero level drops below 4mA, that we don't subject
    the ESP32-S2 to a negative input pin level.
    [LevelAmps.fzz]
2021-06-17 Read levels from ESP32-S2 A/D converter, which is quite noisy (alas)
2021-06-17 Tweaks to LevelAmps (I've forgetten exactly what changed, sorry)
    [LevelAmps.fzz]
2021-06-17 Use external ADC to convert water levels
2021-06-17 Tweaks to rain gauge (show buttons presses, scale barrel levels, etc)
2021-06-17 Slight improvements to rain pump main web page information
2021-06-18 Improve capacitive touch sensing
    Bug fixes from the MPR121 datasheet
    [MPR121.cpp, MPR121.h, esp32-rainbarrel.ino]
2021-06-18 Clean up button press / audio handling
2021-06-18 Add flowmeter source skeleton
2021-06-18 Use "I2C Sender" example
    From https://www.arduino.cc/en/Tutorial/LibraryExamples/MasterReader
2021-06-18 Add target for flowtester based on Feather Huzzah board with OLED display
2021-06-18 Make flowtester functional!
2021-06-18 Ensure rain gauge filter bandwidth isn't thrown off by a display refresh
2021-06-18 Lengthen debounce interval of flowmeter by a smidge
2021-06-22 Fix buglet in order of assignment to lastButtonPress
    [esp32-rainbarrel.ino]
2021-06-22 The buttons on rainpump got wet, so temporarily disable them
2021-06-22 Draft code to read flow meter
2021-06-22 Skeleton to build a raspberry pi pico program for the SMRT-Y snitch
2021-06-23 rainpump: re-enable buttons, adjust max level, less smoothing, enable flowmeter
2021-06-23 rainpump: Suppress zeroes from flowmeter
2021-07-06 Circuits for the SMRT-Y snitch
    First simple version had trouble maintaining the virtual ground.
    It was likely a combination of three things: a wiring error that
    connected somethings to the "real" ground not the "virtual ground",
    overly-large resistors in the reference voltage divider (TL084 has
    input impedance which is significant in this case), and the TL084
    misbehaving when run as a comparator (it doesn't like its outputs
    to be saturated).
    SMRTYSnitch2 used a fancier virtual ground circuit as step 1 in
    addressing this, and reduced the voltage reference voltage divider
    to 100k on each side (from 1M).
    SMRTYSnith3 switched to using a 'real' comparator (LM339 is what
    I had on hand), which ad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
    [SMRTYSnitch.fzz, SMRTYSnitch2.fzz, SMRTYSnitch3.fzz]
2021-07-07 I2C client code for the SMRT-Y snitch
2021-07-07 Use the PIO to blink the LED!
    There's no proper pioasm support in platformio (yet!) but we can
    manually compile our pio files here: https://wokwi.com/tools/pioasm
2021-07-07 First version of SMRT-Y snitch PIO program to capture timer values on edges
2021-07-08 Improvements to the SNITCH_TESTER (nee flowtester)
2021-07-09 snitch: add more testing data, improve algo to handle asym hi/low pulses
    Since our comparator and our phototransistor are both pull-down only,
    the resulting pulses tend to be asymmetric: the rise time is much longer
    than the fall time. DC bias will also cause this. Compensate by allowing
    shorter and longer pulses, but only if they balance out (ie a long pulse
    must be followed by a short one, and vice versa).
    Improve the test infrastructure and add a bunch of new tests to verify
    this new & improved algorithm.
    [boildown.py, desktop.c]
2021-07-09 flowtester: Improve the display, explicitly init buffers
2021-07-09 snitch circuit: Component value tweaks for better performance.
    [SMRTYSnitch3.fzz]
2021-07-10 Improvements to the snitch I2C protocol (and to the flowtester)
2021-07-10 Convert arduino .ino to .cpp
2021-07-11 Add fritzing file for simple comparator circuit
    This uses a two-transistor differential amplifier setup.
    [SMRTYComparator.fzz]
2021-07-11 Rearrange breadboard to use fewer wires
    [SMRTYComparator.fzz]
2021-07-11 SMRT-Y comparator: more breadboard tweaking
    [SMRTYComparator.fzz]
2021-07-12 Reduce pull-down on comparator to ensure we get below 0.8v logic low threshold
    [SMRTYComparator.fzz]
2021-07-12 rainpump/raingauge: Tweak intervals to be prime; slow down SMRT-Y updates
    Adjust all the millisecond intervals to be prime, so that the various timers
    tend to space themselves out over time instead of bunching up on 10s/60s
    boundaries.
    Also send only 2 updates/10s for the SMRT-Y monitor, to avoid throttling
    by adafruit IO. Previously we were generating 6 messages all in very
    short succession which was hitting the rate limiter.
2021-07-12 Initial decode of moisture % and soil temperature!
2021-07-13 Generate one flowmeter datapoint / day
2021-08-13 Update arduino framework to latest git
2021-09-28 Start work on PCBs to use transflective screen and larger waterproof case
    [LCD-panel.kicad_pcb, LCD-panel.sch, Transflective.kicad_pcb, Transflective.sch]
2021-09-28 Reorganize Transflective directories
    [LCD-panel.kicad_pcb, LCD-panel.sch, Transflective.kicad_pcb, Transflective.sch]
2021-09-28 Front panel functionally complete
    Still to do: verify orientation of LCD pinout, add 3.3V regulator option
    [CP_10_9_ADI.step, LCD-panel.kicad_pcb, LCD-panel.sch]
2021-09-28 The FPC connector was mirrored :(
    Add a vertical FPC connector, with the proper orienatation. A bunch of
    stuff needs to be rerouted.
    [LCD-panel.kicad_pcb, LCD-panel.sch]
2021-09-28 Reroute the FPC connector
    [LCD-panel.kicad_pcb, LCD-panel.sch]
2021-10-04 Finish designing front and rear boards for Transflective LCD version
    [B3B-XH-A-LF--SN---3DModel-STEP-269445.STEP, BM04B-SRSS-TB-LF--SN---3DModel-STEP-56544.STEP, LCD-panel.kicad_pcb, LCD-panel.sch, Transflective.kicad_pcb, Transflective.sch]
2021-10-17 Some notes about errata discovered in the v1 PCBs, and BOMs
    [Transflective.sch]
2021-10-20 More PCB notes
2021-11-03 Split snitchtester from flowtester; tweaks to v2tester; start lcdtester
2022-02-04 Gerbers off to JLCPCB for LCD tester board (raspberry pi hat)
    [LCD-Tester.kicad_pcb, LCD-Tester.sch]
2022-03-21 Export PDFs of schematics
2022-03-21 Notes from new LCD testing; raspberry pi software for tester board
2022-03-21 First working version of Adafruit GFX class
    Need to hack the Adafruit_GFX class to get rid of SPITFT and
    GrayOLED in order to remove the dependency on the "standard"
    SPI class. I'll probably just fork Adafruit_GFX to work
    around that...
2022-03-21 Copy esp32 rainpump/raingague code to v2rain.cpp
    Done as a standalone commit so that we can clearly see the changes
    made in the subsequent commit.
2022-03-21 Save memory by using a 2-bit-per-pixel framebuffer for the display
2022-03-22 "Fixup" board for LCD panel, with fixed footprint for LED driver
    Also contains a step-up regulator to generate the LCD voltage of ~17V
    at low current.
    [BM04B-SRSS-TB-LF--SN---3DModel-STEP-56544.STEP, LCD-Fixup.kicad_pcb, LCD-Fixup.sch]
2022-03-29 Port lcdtester to the Huzzah32 (ESP32)
2022-03-29 Port v2tester to the Huzzah32 (ESP32)
2022-03-29 Port the v2 rain gauge client to the ESP32
2022-03-30 Hook up the ADC to the ESP32 rain gauge
2022-04-08 LCD fixup board: ADP1650 (with proper footprint), and external VLED supply
    Support these in the v2tester and the v2 rain gauge.
    [adp1650.h, v2rain.cpp, v2tester.cpp]
2022-10-20 Update rainpump to ESP32; remove support for 8266. Add config screen.
2022-10-24 Update Pico SMRTY snitch code to latest SDK, I2C assignments
    Switched to the earlphilhower SDK, not without some drama.
2022-10-24 Rain pump/gauge ESP32 updates
    * Fix mqtt reconnection logic
    * Add /test webserver endpoint for hardware testing; add more diagnostic
    information to main root webserver endpoint
    * Add some more diagnostic information to Config LCD screen on rain pump
    * Fix some pin configurations for the new V2 pump board
    * Don't allow infinite retry/hang on I2C error to the smrty snitch
    * Be more careful about spamming valve state commands onto the I2C bus
    [v2rain.cpp]
2022-10-24 snitch: Add embedded binary info, fix name of earle philhower port
    [smrtysnitch.cpp]
2022-10-25 Swap CITY/RAIN valve GPIOs
    [v2rain.cpp]
2022-10-25 Add daily flow feed
    Subscribes to Adafruit's hourly time service to stay sync'ed; does one
    update a day at the next hour after the first flow after reboot.
    Needed to fork Adafruit's MQTT library to allow non-blocking handling of
    subscription messages.
    [v2rain.cpp]
2023-06-20 Comments about unimplemented features / bugs
    [v2rain.cpp]
2023-06-23 Remove unused MOTORSHIELD code
2023-06-23 Switch from Adafruit IO to Home Assistant logging
2023-06-27 New PCB for SMRT-Y snitch, skeleton template files
    [Snitch-PCB.kicad_pcb, Snitch-PCB.kicad_sch, Snitch-PCB.sch]
2023-07-04 New Turbine, Level Amp boards (2 versions), and SMRT-Y Snitch board
    Done with KiCAD 7; older designs migrated.
    [Level-Amp-PCB.kicad_pcb, Level-Amp-PCB.kicad_sch, Level-Amp-PCB.sch, Level-Chopper.kicad_pcb, Level-Chopper.kicad_sch, Level-Chopper.sch, Snitch-2.kicad_pcb, Snitch-2.kicad_sch]
2023-07-10 Snitch PCB and BOM
    [Snitch-2.csv, Snitch-2.kicad_pcb]
2023-07-10 Level Chopper PCB, gerbers, BOM
    [Level-Chopper.csv, Level-Chopper.kicad_pcb]
2023-07-10 Level Amp PCB, gerbers, BOM
    [Level-Amp-PCB.csv, Level-Amp-PCB.kicad_pcb]
2023-07-10 Turbine PCB, gerbers, BOM
    [Turbine-PCB.csv, Turbine-PCB.kicad_pcb]
2023-07-30 Remove old esp32-rainbarrel sources
2023-07-30 Document I2C addresses in use
2023-07-30 Fix bug w/ tried to update the pressure sensor from the raingauge
    Also improved the comment, to benefit future-me reading this.
    [v2rain.cpp]
2023-07-30 Add support for multiple flow meters
2023-08-09 Give unique names to the different flowmeters
2023-08-09 Refactor the FOREACH macros a bit for flowmeters
2023-08-09 Print all flowmeter readings on rainpump.local
2023-08-09 Use underscore before index uniformly for rain barrels and flow meters
2023-08-09 Bump up the maximum # of entities per device
2023-08-12 HANumber needs a callback registered or it doesn't record the new value
    [v2rain.cpp]
2023-08-14 Minor improvements to the flowtester/snitchtester
2024-06-13 Add digispark fuse information
2024-06-13 3rd level sensor is now connected
2024-06-18 Set state class for HA binary sensors
2024-06-18 Add hysteresis to water alarm to prevent stuttering
    [v2rain.cpp]
2024-06-18 Ensure pump is off as early as possible in reboot
    [v2rain.cpp]
2024-06-18 Add bounce protection to pump switch
    Don't arc those contacts, it trips the AFCI.
2024-06-18 Different anti-bounce mechanism for pump
2024-06-18 Fix anti-bounce mechanism for pump
    [v2rain.cpp]
2024-06-18 Fixes to built-in webserver; update HA link
    [v2rain.cpp]
2025-11-08 Remove units of measurement from raingauge
    See
    https://github.com/home-assistant/core/issues/155785
    [v2rain.cpp]
2026-05-24 Add raingauge485 target for ESP32-S3 RS485 pressure sensor board
    New PlatformIO environment (esp32-s3-devkitc-1) for a Waveshare
    ESP32-S3-RS485-CAN V2.2 board reading up to 4 QDY30A-B submersible
    pressure sensors via MODBUS RTU over RS485 (IO17 TX, IO18 RX, IO21 DE).
    Includes a web UI at raingauge485.local for viewing raw sensor readings
    and provisioning new sensors by assigning them a MODBUS address (1-4)
    before connecting multiple devices to the same bus.
    Also includes mDNS pump-server discovery and a sendUpdate() stub wired
    up for future integration with rainpump32.
2026-05-24 Cancel page auto-refresh when user focuses address selects
    Replaces the meta http-equiv refresh with a JS setTimeout so it can be
    cancelled via onfocus/onchange on the old/new address select elements,
    preventing the page from wiping out the user's selection mid-form.
    [raingauge485.cpp]
2026-05-24 Implement sendUpdate() in raingauge485: HTTP GET with raw sensor levels
    Sends raw pressure readings to rainpump32 via HTTP GET, packing present
    sensors to the front (first valid sensor → level1, etc.). Fires on any
    level change and every 60 s as a keepalive. Calibration lives on the
    rainpump32 side. Also updates CLAUDE.md with register map and sendUpdate
    behaviour.
2026-05-24 Reduce NUM_BARRELS to 2 in rainpump, and copy values across
    If only one barrel reports, use it as the value for both barrels, etc.
    This ensures that a malfunctioning sensor doesn't cause spurious
    empty/full readings; the remaining sensor values are used instead.
    [v2rain.cpp]
2026-05-24 Add delay after successful read to ensure adjacent sensors work
